Hanjingyu625/SafeStride/docs/HARDWARE.md

# 하드웨어 연결

## 전원

```text
12 V battery -> motor driver
            +-> XL4015 (5 V) -> Raspberry Pi -> USB -> Uno 2대
```

FND 표시가 12 V로 일정해도 Pi 단자의 5 V 순간 강하는 별도 측정해야 한다.
모터 기동 중 XL4015 출력, 배선 전압강하와 Pi undervoltage 기록을 확인한다.
배터리 전압 측정용 분압 회로는 아직 없으므로 Arduino A5에 12 V를 직접 연결하면
안 된다.

## Drive Uno

| 핀 | 연결 |
|---:|---|
| A3 | 왼쪽 휠 WSH135 `OUT`, 아날로그 기준점/히스테리시스 감지, 자석 12개 |
| D5/D6/D8 | 공통 모터드라이버 PWM/IN1/IN2 |
| A2/A1 | 왼쪽/오른쪽 압력센서, threshold 80 |
| A0/A4 | 선택적 전류센서 예약, 현재 비활성 |
| D12 | E-stop placeholder, currently unused |
| D13 | 선택적 driver fault, 기본 비활성 |

두 모터는 한 드라이버 출력에 연결되므로 서로 다른 속도나 제자리 회전은 지원하지
않는다. 두 모터 합산 기동·정지전류가 드라이버, 퓨즈, 배선 허용치를 넘지 않는지
확인한다.

WSH135는 5 V 구동 선형 아날로그 센서다. 마킹이 보이는 평평한 면을 정면으로
보고 다리를 아래로 했을 때 왼쪽부터 `VDD -> 5V`, `GND -> GND`,
`OUT -> A3`로 연결한다. 출력에는 풀업/풀다운 저항을 달지 않는다. 필요하면
`OUT-GND` 사이에 0.01~0.1 uF 커패시터를 센서 바로 옆에 단다. 부팅 중 학습되는
약 2.5 V 무자계 기준을 오염시키지 않도록 전원을 넣을 때 자석을 떼어 둔다.
바퀴 지름은 23 cm, 반지름은 0.115 m로 설정한다.

## Terrain Uno

| 핀 | 연결 |
|---:|---|
| A4/A5 | TOF-10120(`0x52`)와 GY-521 MPU6050(`0x68`/`0x69`) SDA/SCL |
| GND | 모든 센서와 공통 GND |

TOF는 아래쪽을 향해 약 25 cm 높이에 고정하고 장착부 흔들림이 거리 변화로
들어오지 않게 한다.

## Raspberry Pi GPS

BE-220은 Pi GPIO UART를 통해 Raspberry Pi에 직접 연결하고, 운영 장치 이름은
`/dev/serial0` 또는 `/dev/ttyS0`, 기본 baudrate는 115200이다. 실행 스크립트가
두 경로를 자동 선택하며 필요하면 `SAFESTRIDE_GPS_PORT`로 지정한다. GPS와 Pi의
GND를 공유하고 TTL 전압 레벨이 Pi 입력 허용 범위와 맞는지 확인한다.
