Hanjingyu625/SafeStride/docs/SPEED_CONTROL_KO.md

# SafeStride 속도제어 — pdj1

현재 동작: 내리막 5°가 0.5초 지속되어 확정되면 BRAKE/PWM 0.

기준: 현재 저장소의 실행 코드와 설정.
이 문서는 코드 동작과 초기 튜닝값을 설명한다. 실제 지면 속도·정지거리·경사 위
정지 유지 성능은 아직 측정하지 않았다.

## 1. 제어 흐름

```text
Terrain Uno MPU6050 → USB → terrain bridge → /terrain/status
                                                 ↓
/cmd_vel → safety supervisor → /drive/command (DriveCommand)
                                   ↓
                              serial bridge
                                   ↓ USB protocol v6
Drive Uno: 목표 ramp → FF + Hall P → 방향/상한 제한 → PWM slew → 모터드라이버
                ↑                                       ↓
          A3 WSH135, 12 pulse/rev                   모터 두 개 공통 구동
```

`/cmd_vel_safe`는 감독된 목표속도를 관찰하기 위한 `TwistStamped`로 유지한다.
실제 bridge 입력은 `/drive/command`이며 목표속도·경사 FF·상한·mode가 한 메시지다.
속도와 경사 보정을 별도 토픽으로 보내 이전 보정이 새 속도에 섞이게 하지 않는다.

주요 코드:

- `firmware/safestride_mcu/config.h`, `motor_control.cpp`: FF, Hall, PWM, BRAKE.
- `src/safestride_control/safestride_control/safety_logic.py`: 경사 분류와 BRAKE 복구.
- `safety_supervisor_node.py`: 센서 freshness, 속도 제한, 원자 명령 발행.
- `src/safestride_bridge/safestride_bridge/serial_bridge_node.py`: 명령 검증·직렬 전송.
- `config/raspberry_pi.yaml`, `src/safestride_bringup/config/safestride.yaml`: 실행 설정.

## 2. 평지 출력과 속도 피드백

PWM은 Arduino `analogWrite()`의 **0~255 count**다. 60은 60%가 아니라 약 23.5%
duty다. 30은 약 11.8%, 현재 상한 140은 약 54.9%다.

```text
wheel_radius = 0.115 m
v_nom = 1.0 m/s
omega_nom = 1.0 / 0.115 ≈ 8.696 rad/s

u_ff = sign(omega_ref) × [30 + (60 - 30) × abs(omega_ref) / omega_nom]
u_P  = 12 × (omega_ref - omega_measured)     # rad/s 단위
u_raw = u_ff + u_slope + u_P
```

목표가 0이면 BRAKE다. 매우 작은 ramp 목표(|목표| < 20 mrad/s)의 FF도 0이다.
`30`은 계산 bias이며 출력 하한이 아니다. 전진 목표에서 출력은 0~cap, 후진에서는
-cap~0으로 제한하므로 감속 중 30 아래나 0까지 내려갈 수 있다. 속도 오차만으로
목표 반대 방향 PWM을 만들지 않는다. Ki=Kd=0을 코드 assertion으로 고정했다.

평지에서 목표·측정 속도가 모두 1.0 m/s이면 모델 출력은 약 60이다.
이는 실측 보정 전 초기 기준이며, 부하에 따라 P 항이 출력을 수정한다.
기존 `MOTOR_FEEDFORWARD=10`과 deadzone bias 중복 덧셈은 제거했다.

최초 전진 구동은 제어 출력과 cap 범위 내에서 PWM 20까지 바로 시작한다.
이후 정상 PWM 크기는 상승 20 count/s, 하강 60 count/s로 제한한다. 출력
20→60은 목표·오차가 충분하더라도 약 2초 이상 걸린다. Pi 목표속도 slew 및 MCU
목표각속도 ramp와 최종 PWM slew는 별개다. 새 cap은 즉시 지킨다.
BRAKE·fault·watchdog은 정상 slew를 기다리지 않는다.

## 3. 경사 보정

정규화는 `(pitch_rad - pitch_offset_rad) * uphill_pitch_sign` 순서다.
현재 supervisor offset `0 rad`, sign `-1`이다. Pitch 양수는 내리막, 음수는 오르막이다.
Terrain bridge가 평지 기준 Pitch `-0.116 rad`(-6.646310°), Roll `-0.059 rad`(-3.380451°)를
한 번 빼서 `/terrain/status`를 발행한다. Foxglove와 HMI, 경사 제어는 이 보정값을 사용한다.
supervisor와 HMI의 추가 offset은 `0`으로 유지해 중복 보정을 피한다.
아래 각도는 모두 보정 후 값이다. `/terrain/imu`는 중력 제거 계산과 일관되도록
센서 좌표계의 기존 자세·가속도를 유지한다. 현재 영점은 평지 화면 한 장 기준이므로
재장착 시에는 정지 상태의 여러 샘플로 `terrain_bridge.attitude` 설정을 다시 보정한다.

아래 표는 기본 Cruise 요청 1.0 m/s와 현재 Pi 설정 기준이다.

| 보정 후 Pitch / 조건 | 목표속도와 출력 동작 |
|---|---|
| 평지 | 목표속도 1.0 m/s |
| 내리막 +5° 미만 (평지에서 진입) | 목표속도 1.0 m/s 유지 |
| 내리막 +5° 이상 0.5초 유지 | 목표 0과 BRAKE를 보내 PWM 즉시 0, IN1/IN2 LOW |
| 내리막 +7° 이상, 5° 확정 전 | 진입 당시 PWM에서 3초 감속을 먼저 시작; 5° 확정 시 BRAKE/PWM 0이 우선 |
| 확정 내리막 후 +3° 이하 | 0.5초 유지 시 평지로 복귀하고 정상 출발 경로 재개 |
| 오르막 -5° 이하 0.5초 유지 | 목표속도 1.0 m/s 유지, 최대 +30 PWM 경사 FF |

오르막 상태는 -3°까지의 히스테리시스로 유지되며, 양의 경사 FF는 -5°보다
완만해지면 0이 된다. 속도 피드백과 손잡이/통신 정지는 표보다 우선한다. ToF는 현재 모니터링 전용이다.
FF 60은 명목속도의 계산값이며 PWM 하한이 아니다. Ki=0을 유지한다.
PWM을 0으로 줄이는 시간과 실제 보행기의 제동거리/정지시간은 별도로 검증한다.

Pi 실행 시 다른 checkout의 설정이 환경변수에 남지 않도록 경로를 명시한다:

```bash
cd /home/pi/SafeStride-pdj1
SAFESTRIDE_CONFIG="$PWD/config/raspberry_pi.yaml" SAFESTRIDE_ENABLE_FOXGLOVE=true bash scripts/run.sh
```

경사 상태 진입 5°, 이탈 3°, 확인 0.5초의 히스테리시스를 사용한다.
오르막 목표속도 배율은 **1.0**으로 요청 속도를 유지하고 PWM 보상만 더한다.
기존 최대 전진속도 1.15 m/s와 가감속 제한은 유지한다. `downhill_speed_scale=1.0`이며
확정 내리막은 속도 배율 대신 `BRAKE`로 처리한다. 5° 확정 전 +7°가 먼저 감지되면
기존 3초 PWM 감속을 시작하지만, 0.5초 뒤 내리막이 확정되면 즉시 PWM 0이 우선한다.
이 7° 감속이 시작된 경우 MCU는 경사가 해제된 뒤에도 남은 감속 시간을 0 출력으로 완료한다.
평지 복귀는 +3° 이하가 0.5초 지속돼야 한다. 속도 피드백, 손잡이 및 통신 정지는
그대로 우선한다. ToF 정지는 현재 비활성이다. PWM 상한 140은 ROS 명령·브리지·Drive MCU에
함께 적용하므로 Pi 소프트웨어와 Drive 펌웨어를 함께 갱신해야 한다.

| 확정 상태 | 경사 FF (PWM count) |
|---|---|
| 평지 | 0 |
| 오르막 | `min(30, max(0, 5 × (각도 - 3)))` |
| 내리막 | 0 |

오르막 FF는 보정 후 -5° 이하이고 오르막 상태가 확정됐을 때 적용한다.
보정 후 -5°에서 +10, -7°에서 +20, -9° 이하에서 +30이다. 기본 FF 60은 명목속도에서의
계산값이지 실제 PWM 하한이 아니다. 실제 출력은 FF와 P, PWM 상한과 slew로 결정된다.
후진 명령에는 전진 기준 경사 FF를 적용하지 않는다. MPU의 현재 pitch는 가속도
기반 추정이므로 가감속·충격 영향을 받는다. 위 값은 검증된 보행 안전 기준이 아니다.

## 4. BRAKE 유지와 자동 복귀

사용자가 지정한 [DFRobot DRI0042 제어 자료](https://wiki.dfrobot.com/dri0042/#tech_specs)를
기준으로 `IN1=LOW, IN2=LOW`를 BRAKE로 사용한다. `HIGH/HIGH`는 Vacant이며 사용하지 않는다.
PWM 핀은 0으로 두지만 보드 전원은 유지하고 BRAKE 핀 상태를 계속 유지한다.
전원 릴레이 차단이나 새 수동 재시작 잠금을 추가하지 않았다.

참고 자료는 **DRI0042**의 문서이며 장착품 명칭은 **SZH-GNP521**이다.
장착 보드 리비전의 일치와 실제 BRAKE 효과는 실물 확인 대상이다.
방향 전환에는 자료의 0.1초 초과 권고를 반영해 최소 150ms BRAKE를 비차단 방식으로 둔다.
역방향 PWM을 제동으로 사용하지 않는다.

| 조건 | 동작·복귀 |
|---|---|
| 보정 후 pitch ≥ +5°가 0.5초 지속 | 확정 내리막 BRAKE. 목표 0, PWM 0, IN1=IN2=LOW. +3° 이하가 0.5초 지속되면 자동 복귀 |
| 보정 후 pitch ≥ +7°, 확정 전 | MCU TERRAIN_STOP으로 3초 PWM 감속 시작. 내리막 확정 시 BRAKE가 우선 |
| MPU invalid, fault, nonfinite 또는 stale | BRAKE 명령 스트림 유지. 유효 복구 조건에서 자동 재개 |
| 새 Hall 구간속도 >8 km/h가 2회 연속 관측 | MCU BRAKE |
| 과속 후 새 Hall 구간속도 <7 km/h | 자동 복귀 |
| 과속 후 새 pulse가 5초간 없음 | 무펄스 복구 조건으로 자동 복귀 가능. 물리 정지를 증명하지 않음 |
| 요청속도 0 | BRAKE. 정상 손 해제 ramp는 아래 예외 |

목표 대비 일반 속도 오차는 Hall P 제어가 PWM을 낮춰 보정한다. MCU의 독립적인
하드 BRAKE는 절대속도 8 km/h를 넘는 새 pulse-period가 2회 연속 관측될 때만
작동한다. 같은 저해상도 측정값을 200Hz 제어 주기마다 반복해 지속 과속으로
오인하지 않는다. 12 pulse/rev의 관측 지연 때문에 즉각적인 과속 감지는 불가능하다.

**기존** 양손 dead-man, 통신 watchdog, 하드웨어 fault, 수동 inhibit는 유지했다.
정상 손 해제는 기존 600ms 동안 직전 출력부터 단조 감소시킨다. E-stop 설정은
기존과 같이 비활성이며, 통신/하드웨어 fault는 기존 상태기계의 정지·복구 절차를 따른다.
새 경사 BRAKE 자체는 `ARMED`를 유지하므로 별도 재시작 버튼을 요구하지 않는다.

단락 BRAKE는 기계식 주차 브레이크가 아니다. 영속도에서 경사 위 위치를 유지하거나
전원이 없는 상태에서 제동을 보장하지 않는다. 이 구현에 기계적 HOLD는 없다.

## 5. Hall 5초 설정과 측정의 의미

한 pulse 이동거리는 `2π × 0.115 / 12 ≈ 0.0602 m`다.

| 실제 속도 | pulse 간격 |
|---:|---:|
| 0.08 m/s | 0.75초 |
| 0.048 m/s | 1.25초 |
| 0.04 m/s | 1.51초 |
| 0.032 m/s | 1.88초 |

`HALL_ZERO_TIMEOUT_US=5000000`으로 연장했다. 유효 speed는 pulse period가
20ms 이상·5초 미만이고 마지막 pulse age도 5초 미만인 경우다. 첫 pulse만으로는
속도를 만들지 않는다. 필터는 새 pulse가 들어올 때만 갱신한다.
5초 이후 표시 속도는 0으로 정리하되 `speed_valid=false`로 구분하고 P에는 넣지 않는다.

초기/무효 측정에서는 P=0, FF 요구를 최대 60으로 제한한다. 이미 더 큰 출력으로
주행했다면 정상 하강 slew로 줄어든다. 무펄스 구동 감시는 30 미만 출력도 포함하며
`max(5초, 예상 pulse 간격 × 2.5)`를 쓰되 최대 10초로 제한했다. 따라서 0.032 m/s에서
최소 5초, 0.08 m/s에서는 최소 5초를 기준으로 스톨을 감시한다.
5초는 속도 age timeout이며 스톨 timeout과 같지 않다.

12자석에서 8 km/h의 펄스 간격은 약 27.1ms다. 20ms pulse 무시 구간은
이 속도를 검출할 수 있다. ADC 30/12 히스테리시스는 유지했다.
빠른 ADC pulse를 실제 입력 검출 경로로 통과시키는 회귀 테스트를 추가했다.
노이즈·자석 폭·배선 EMI에 따른 오검출은 실물 튜닝이 필요하다.

## 6. 진단과 업데이트

2026-09-09 설정: 자석 12개, 과속 BRAKE 진입 8 km/h 초과의 새 구간속도
2회 연속 확인, 해제 7 km/h 미만. 두 번째 확인 즉시 PWM 0을 적용한다.
Hall 물리 상한은 25 rad/s(10.35 km/h)로 높여 8 km/h 전에 fault가 걸리지
않게 했다. 주행 목표속도와 PWM 상한은 별도 설정이다.

ROS 제어·표준 메시지 단위는 m/s, rad/s를 유지하고 다음 km/h 표시를 제공한다.

| 토픽 | km/h 값 |
|---|---|
| `/wheel/hall` | `left_speed_kmh`, `right_speed_kmh` |
| `/walker/status` | `measured_speed_kmh` |
| `/drive/command` | `target_speed_kmh` (표시용) |
| `/crosswalk/status` | `target_speed_kmh` |
| `/gps/speed_kmh`, `/gps/speed_raw_kmh` | `data` |
| `/odom_kmh`, `/cmd_vel_kmh`, `/cmd_vel_safe_kmh` | `data` (전후진 선속도) |

마지막 두 행은 launch에서 시작하는 `speed_display`가 원본 메시지 수신 시
발행한다. 원본이 끊기면 표시 토픽도 발행을 멈춘다. Foxglove Speed 축도 km/h다.
메시지 정의가 추가됐으므로 Pi에서 인터페이스와 관련 ROS 패키지를 함께 재빌드하고
노드를 재시작해야 한다. Drive Uno에는 12자석 설정 펌웨어를 업로드해야 한다.

`/walker/status`에 `ff_pwm`, `feedback_pwm`, `applied_pwm`, `measured_speed_m_s`,
`speed_age`, `speed_valid`, `new_pulse`, `braking`, `direction_valid`가 있다.
`new_pulse`는 직전 성공 telemetry 전송 이후 pulse가 있었음을 뜻한다.
오른쪽 속도는 왼쪽 복제값이고 `direction_valid=false`다.
상태 메시지가 반복돼도 새로운 물리 측정이 생긴 것은 아니다.

`/diagnostics`에는 정규화 pitch·경사 상태·목표속도·slope FF·MCU PWM·속도 age/valid와
BRAKE 상태를 기록한다. 명시적 경사·과속 BRAKE 처리 시 MCU FF/P 표시값과 applied PWM은 0이다.

프로토콜 **v6 / schema 0x0601 / release 20260908**은 이전 버전과 호환되지 않는다.
COMMAND는 12 bytes, Drive telemetry는 54 bytes다. [상세 형식](../PROTOCOL.md).
**Drive Uno, Terrain Uno, Pi ROS 메시지와 노드를 함께 갱신**해야 한다.

```bash
# Pi에서 저장소를 pdj1로 갱신한 뒤, 구동 서비스를 정지한 상태에서 수행
bash scripts/build.sh
arduino-cli compile --fqbn arduino:avr:uno firmware/safestride_mcu
arduino-cli compile --fqbn arduino:avr:uno firmware/terrain_mcu
# 포트 확인 후 각각 upload. 이 코드 작업에서는 실제 업로드하지 않았다.
arduino-cli upload --fqbn arduino:avr:uno -p /dev/safestride-drive firmware/safestride_mcu
arduino-cli upload --fqbn arduino:avr:uno -p /dev/safestride-terrain firmware/terrain_mcu
SAFESTRIDE_ENABLE_PERCEPTION=false SAFESTRIDE_REQUIRE_SURFACE_CONDITION=false \
  SAFESTRIDE_ENABLE_CRUISE=false bash scripts/run.sh
```

이전 `tools/windows_uno_test.ps1`은 v2 도구여서 이번 프로토콜에 사용하지 않는다.
읽기용 연결 검사는 현재 Python 프로토콜을 쓰는 `tools/serial_probe.py`를 사용한다.
노면 활성화 후속 계획은 [MCU README](../firmware/safestride_mcu/README.md)에 있다.

## 7. 검증과 다음 실물 시험

로컬 검증 결과: Drive/Terrain Uno AVR 컴파일과 C++ 호스트 펌웨어 8종 통과.
Python 62개(bridge/프로토콜 36, 감독 명령 7, 경사 정책 6, 설정 일치 13) 통과.
두 실행 YAML의 파싱 및 노면 비활성·오르막 배율 1.0 확인, Python compileall 통과.
최종 Drive 빌드는 flash 15,230/32,256 bytes, 전역 RAM 988/2,048 bytes,
Terrain은 flash 10,648 bytes, 전역 RAM 1,065 bytes다.
이 검사는 실제 DDS 통신, Pi에서의 ROS 실행, USB 연결, 모터 부하 시험을 대체하지 않는다.

Deployment note: nominal walking speed is 1.0 m/s; uphill target stays at 1.0 m/s with PWM assistance.
ROS forward limit is 1.15 m/s and bridge/MCU wheel limits are 10 rad/s.
FF 60 at 1.0 m/s is an initial model requiring loaded hardware calibration.
Deploy both ROS configuration and Drive Uno firmware together.

### ToF·노면 모니터링 설정

현재 기본 설정은 `terrain_stop_enabled=false`, `range_control_enabled=false`,
`require_range_sensors=false`, `surface_control_enabled=false`,
`require_surface_condition=false`이다. ToF 위험·오류, 전방 거리, 노면 분류와
권장 배율은 모터 명령을 변경하지 않는다. 영상과 센서·판정 토픽은 계속 발행한다.
MPU의 5도 확정 내리막 PWM 0과 7도 조기 감속, 손잡이·통신 보호는 유지한다.
