Hanjingyu625/SafeStride/docs/ROADMAP.md

# Integration roadmap

- [x] 왼쪽 A3 WSH135 Hall 12 pulse/rev와 압력 threshold 80 반영
- [x] TOF EMA, 적응 기준, 양방향 변화와 연속 검출 구현
- [x] GY-521 MPU6050 3축 가속도·자이로 구현
- [x] BE-220 GPS 기본 활성 및 지도/API readiness monitor 구현
- [x] ROS launch integration test와 안전한 HIL smoke test 추가
- [ ] 휠 반지름과 PID를 lifted-wheel 로그로 조정
- [ ] XL4015 5 V 과도응답과 모터 기동 시 Pi undervoltage 측정
- [ ] TOF를 발, 경사, 반사면, 구멍 조건에서 데이터 수집 후 임계값 조정
- [ ] 횡단보도 지도와 신호 API를 준비한 뒤 관찰 로그로 검증
- [ ] 물리 E-stop 설치 및 독립 전원 차단 검증
- [ ] 기계·전기 안전 검토 후 무부하 저속 시험
