Hanjingyu625/SafeStride/docs/SIGNAL_REALTIME_UPDATE_KO.md

# 실시간 신호 API 및 판단 변경 (2026-09-29)

## 이전 조회 방식의 실제 확인 결과

사용자가 승인받은 두 실시간 API를 기존 저장 키로 직접 확인했다.
승인 화면의 키 문자열과 로컬 `raspberry_pi/api_key.txt`가 일치했다.
광진구청 교차로 1697 조회에서 두 API 모두 HTTP 200을 반환했다.
이어 수정한 클라이언트로 약 1초 간격 5회 조회하여 모두 정상 수신했다.
동/서 보행신호는 빨간불이었고 잔여시간은 36001(사용 불가)이었다.
빨간불은 잔여시간 없이도 확인되므로 이 응답은 '신호 없음'이 아니라 '기다려'다.
녹색 판정은 테스트 데이터로 검증했으며, 이번 실제 5회 수신은 모두 빨간불이었다.

## API와 자동 실행

기본 요청 주소는 승인 화면과 동일하다.

- 현시: `https://t-data.seoul.go.kr/apig/apiman-gateway/tapi/v2xSignalPhaseCurrentInfo/1.0`
- 잔여시간: `https://t-data.seoul.go.kr/apig/apiman-gateway/tapi/v2xSignalPhaseTimingCurrentInfo/1.0`

둘 다 소문자 `apikey`와 동일한 `itstId`로 병렬 조회한다.
현재 작업 트리(`a6a1a7b` 이후 0초 응답 처리 변경 포함)는 기본적으로 **잔여시간 만료 시 재조회**한다.
횡단보도 좌표는 로컬 JSON, 교차로 지도는 디스크 파일/캐시를 사용한다.
선택 횡단보도 가장자리 20m 안에서 단일 보행 신호 방향이 확인되면 빨강·초록 모두
현시와 잔여시간 API를 병렬 조회한다(한 조회에 HTTP 요청 두 건).
최초 응답은 원본 나이 12초 이내인지 검증하고, 수용한 현시의 종료 시각까지
라즈베리파이가 잔여시간을 계산한다. 20초 남은 원본이 2초 늦게 도착하면 18초 후
재조회하며, 그동안 3초 주기 조회는 하지 않는다. 만료 후에는 새 응답이 있어야
신호색을 다시 판단한다. 보고된 종료 전 현장 신호 변경을 즉시 감지하지 못하는 한계가 있다.

`signal_refresh_interval_s=3`은 실패·누락 및 새 선택 시 최소 요청 간격이다.
서버가 지정한 HTTP 오류 대기는 유지한다. 잔여 호출량으로 평균 간격을 계산하는
자동 pacing은 이 노드에서 끄며, 과거 pacing 캐시도 재사용하지 않는다.
빨강 잔여시간이 없으면 원본 나이 12초 안에서 대기를 표시하며 재조회한다.
잔여시간이 **0으로 응답되면 빨강 색상은 원본 12초 동안 유지**하고, 응답 수신 후
2초 간격으로 최대 3회 추가 조회한다. 초록 0초도 같은 재조회 제한을 적용하되 진입은 불허한다.
계속 0이거나 실패하면 3회 후 해당 교차로·방향의 자동 조회를 중단한다. 선택 변경으로
횟수를 초기화하지 않는다. 유효한 양수 시간이 새로 관측되거나 노드가 재시작되면 해제된다.
중복 원본은 색상 유효기간을 연장하지 않으며, 서버 오류 대기는 2초 간격보다 우선한다.
이 0초 예외에서는 표시용 잔여시간은 null, 진입 계산용 빨강 시간은 0이다.
녹색 잔여시간이 없으면 진입을 허용하지 않는다.
`signal_countdown_s`는 현재 빨강/초록 잔여시간이고, 기존 `signal_remaining_s`는
녹색 시간 예산이므로 빨강에서는 0이다.
자세한 조건은 [속도·신호 역치 문서](SPEED_CHANGE_THRESHOLDS_KO.md)의 최신 절을 따른다.

원본 시각은 관측 중 약 2초 단위로 갱신되기도 했다. 1초 조회가 서버 갱신을
빠르게 만들지는 않는다. 동일 응답을 새 데이터로 취급하지 않고 원본 시각을 사용한다.
HTTP 429는 응답 JSON 내부 `X-RateLimit-Reset`도 읽는다. 2026-09-29 15:59:40 KST의
실제 응답 `28819초`는 23:59:59 KST에 해당하여 현재 제한은 자정 초기화로 관측됐다.
로컬 캐시 삭제로 서버 사용량은 초기화되지 않는다.
신호를 잃어도 오래된 데이터를 계속 유효하게 연장하지 않는다.

## 횡단보도와 신호 그룹 매칭

서울시 공식 설명에서 보행신호 방향은 횡단보도 자체의 방위가 아니다.
차량이 직진할 때 그 횡단보도를 오른쪽에 두는 진입 방향의 신호 그룹을 사용한다.
따라서 교차로 서쪽 횡단보도는 `wtPdsg*`가 아니라 `ntPdsg*`에 해당한다.
코드는 교차로 중심에서 횡단보도로 향하는 방위에 90도를 더한 뒤,
횡단보도 장축과 일치하는지 확인해 `nt/et/st/wt` 또는 대각선 그룹을 고른다.
연결된 방향만 판정하며 다른 방향의 색이나 잔여시간으로 후보를 제외하거나 값을 합치지 않는다.
2026-09-30 로컬 변경 (`8b80341` 이후): 기하가 애매하면 같은 교차로의 이전 확정
방향에 가까운 후보를 임시 조회한다. 확정 이력이 없으면 유지되는 랜덤 후보 하나를
선택하고 정상 신호 검증·진입 판단에 사용한다. 랜덤 선택의 출처는 `random_candidate`로
남기며 실제 횡단보도와 신호 그룹의 일치를 보장하지 않는다. API 응답 유효성·색·잔여시간
검증은 유지한다. 이전 확정 방향 기반 임시 조회는 `provisional_signal_*`에만 제공한다.
교차로 중심 최소 거리 역치는 1m다. 자세한 기준은 SPEED_CHANGE_THRESHOLDS_KO.md 최신 절을 따른다.

공개된 `신호연결 MAP 정보` CSV도 확인했으나 차량 차로의 직진/좌회전/우회전 연결만
포함하고 보행 횡단보도 좌표나 보행신호 연결은 포함하지 않는다. 이 파일은 현재
보행신호 매칭을 대체할 수 없다.

신호 주기는 시간대, 보행자 버튼, 교통 대응 및 현장 설정에 따라 달라질 수 있으므로
관측한 반복 주기를 실제 녹색 또는 진입 허가로 사용하지 않는다. 대회 시연도 20m 안에서
받은 실시간 현시를 사용하며, API가 없으면 `신호 없음`으로 표시한다.

기존 `scripts/run.sh`와 서비스 시작 방식은 그대로 사용한다. 키는 매번 입력하지 않는다.
노드 자체도 다음 순서로 저장된 키를 자동 로드한다.

1. 명시한 `api_key_file`, 또는 `SAFESTRIDE_SIGNAL_API_KEY_FILE` 경로
2. 별도 지정이 없으면 `/etc/safestride/signal_api_key.txt`
3. 위 기본 파일에 키가 없으면 체크아웃의 `raspberry_pi/api_key.txt`

명시한 경로가 잘못됐을 때 다른 키로 몰래 바꾸지는 않는다.
run.sh가 전달하는 키 경로가 있으면 그 경로가 우선한다. 서비스 재시작 시 자동으로 읽는다.
현재 저장 키가 새 승인 키와 같으므로 키 내용 교체는 필요하지 않았다.

## 직관적인 판단

| 상황 | guidance decision | 표시 |
|---|---|---|
| 진입 지점에서 녹색이고 필요한 시간이 충분 | GO | 건널 수 있음 |
| 진입 전 빨간불 또는 녹색 시간이 부족 | WAIT | 기다려 |
| 횡단 중 남은 시간이 부족하거나 ETA/완료 확인 불가 | CAUTION | 주의 |
| 신호 누락, 오래된 신호, 방향/현시/필수 잔여시간 미확정 | NO_SIGNAL | 신호 없음 |

접근 중에는 진입 지점에서 재확인하도록 WAIT를 유지한다.
선택된 횡단보도가 없거나 횡단 완료 상태에는 NONE/안내 없음이다.
횡단 중 신호가 사라지면 NO_SIGNAL로 실제 신호 확인을 안내한다.
이미 도로 위에 있을 때 진입 전 '기다려' 판단으로 되돌리지 않는다.

진입 필요시간 = 횡단보도 길이 / 사용자 보행속도 + 반응 1초 + 여유 2초.
사용자 속도는 확인된 이동 표본의 중앙값이며, 대기 속도는 학습하지 않는다.
표본이 없을 때 기존 기본값 1.0m/s를 사용한다. 이 값은 실제 모터 속도 보장이 아니다.
예: 길이 10m, 사용자 속도 1m/s이면 13초가 필요하다. 남은 녹색 18초면 진입 가능,
10초면 대기다. 속도가 0.35m/s이면 약 31.6초가 필요하므로 18초에는 대기한다.

횡단 중 ETA = 남은 거리 / 현재 측정속도.
남은 녹색이 ETA + 2초보다 짧으면 주의다. 정지/속도 누락은 ETA 미확정이다.
시간 계산과 여유값 자체는 이번 변경으로 늘리거나 줄이지 않았다.
녹색은 실제 현시 이름으로 확인하고, 유효한 잔여시간에서 원본 데이터 나이를 뺀다.
36000/36001/-1은 잔여시간으로 사용하지 않는다. 빨간불의 남은 시간을 녹색 시간으로 쓰지 않는다.

## 호환성과 확인

`/crosswalk/status`의 내부 state 0~6, 횡단 시작/완료, GPS 후보 유지,
바퀴 이동 확인, 모터 제어 및 LCD 통신 형식은 유지한다.
LCD는 기존 status의 signal_valid/state를 계속 받는다. LCD 문구 자체는 변경하지 않았다.
사람이 읽을 판단은 `/crosswalk/guidance`의 decision/state/reason으로 확인한다.
signal_color는 RED/GREEN/UNKNOWN, 나머지 계산값과 매칭 원인도 함께 제공한다.
지도 기반 신호 방향은 공식 규칙에 맞춰 계산하지만 입력 좌표 오차가 있으므로
대회 전 대상 횡단보도에서 실제 신호등과 한 번 대조해야 한다.

```bash
ros2 topic echo /crosswalk/guidance
```

서비스와 중복 조회하지 않는 별도 점검 시 저장 키를 자동으로 사용한다.

```bash
python3 tools/probe_signal_current.py --intersection 1697 --samples 5
```

이 도구는 운영 코드와 같은 조회/파싱/오류 대기 로직을 사용하고 최대 30회로 제한한다.
구형 API를 조회하던 legacy-check 및 키 인자 대소문자 수동 선택 옵션은 제거했다.

검증: GPS/내비게이션 자동 테스트 통과. 실제 API 5회 연속 수신 성공.
이 변경의 Pi 재배포/현장 주행 결과를 의미하지는 않는다.
