Hanjingyu625/SafeStride/docs/analysis/ROSBAG_TIME_MARKERS_KO.md

# 로스백 분석용 시각 메모

| 시각(KST) | 시각(UTC) | 사용자 지정 내용 | 기록 파일 |
|---|---|---|---|
| 2026-09-28 18:06:37 +09:00 | 2026-09-28 09:06:37Z | 오르막·내리막(up/down hill) 로스백 분석 시 참고할 현재 시각 | 아직 확인하지 않음 |

사용자의 시각 표시 요청을 받은 뒤 PC 시계로 확인한 시각이다. 실제 경사 진입·종료 시각이나 녹화 시작 시각을 측정한 것은 아니다. 2026-09-27 기록과 구분하여 해당 날짜의 로스백에서 이 시각 전후를 확인한다.
