Hanjingyu625/SafeStride/docs/assets/road_surface_panel/road_surface_training_summary.pdf

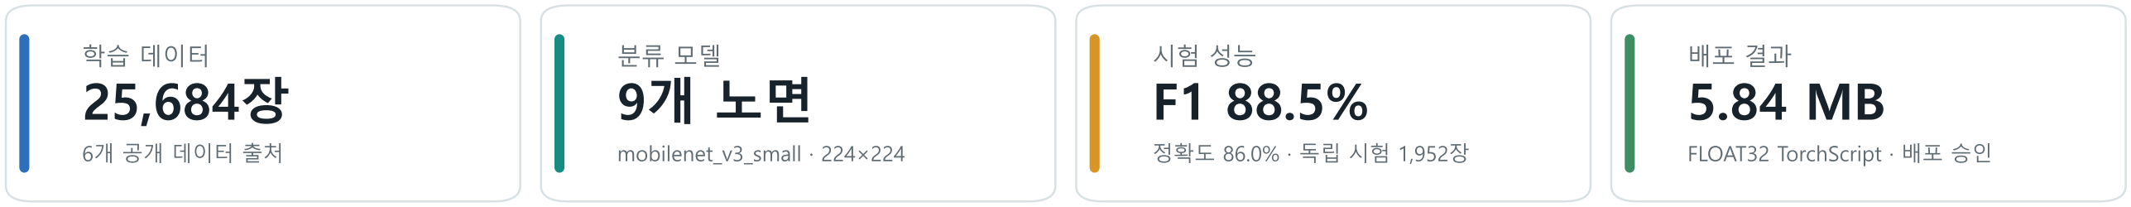
[picture p3: figure]
학습 데이터 25,684장; 6개 공개 데이터 출처; mobilenet_v3_small · 224×224; 정확도 86.0% · 독립 시험 1,952장; FLOAT32 TorchScript · 배포 승인
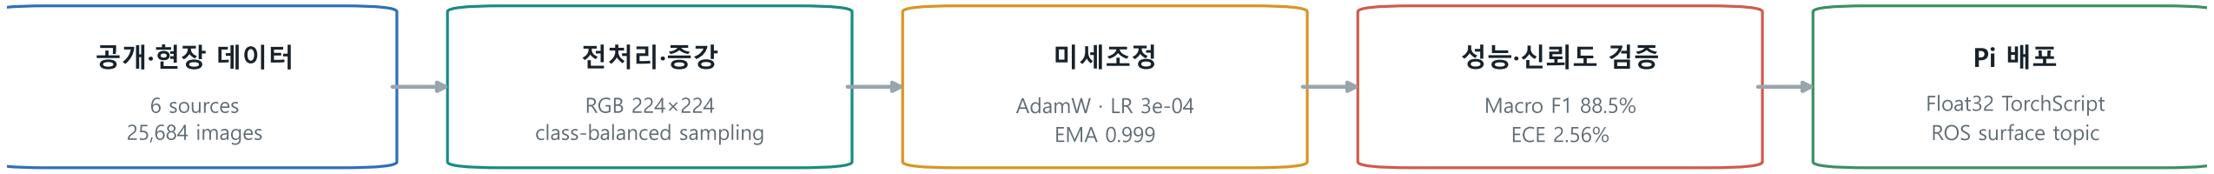
[picture p4: figure]
공개·현장 데이터; 6 sources 25,684 images; 전처리·증강; RGB 224×224 class-balanced sampling; 미세조정; AdamW · LR 3e-04 EMA 0.999; 성능·신뢰도 검증; Macro F1 88.5% ECE 2.56%; Float32 TorchScript ROS surface topic

# 데이터 출처별 이미지 수

# 핵심 학습 설정

Architecture | mobilenet_v3_small
Input | RGB 224×224
Optimizer / batch | AdamW / 128
Learning rate | 3e-04 / backbone 3e-05
Training schedule | max 30 epochs / early stop 7
Regularization | WD 1e-04 / smoothing 0.05
Model averaging | EMA 0.999
Train / val / test | 22,697 / 1,035 / 1,952

# 노면 인식 모델 학습 및 배포 개요

## SafeStride · MobileNetV3-Small · Raspberry Pi 실시간 추론

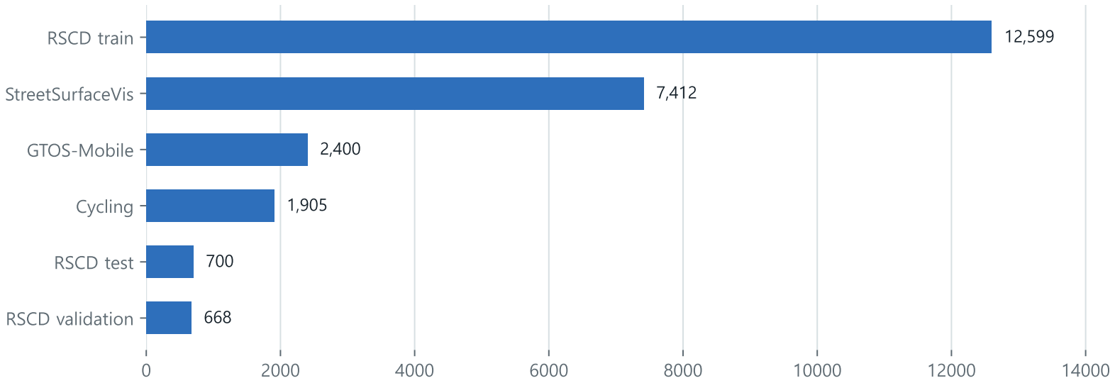
[picture p5: figure]
RSCD validation; RSCD test; Cycling; GTOS-Mobile; StreetSurfaceVis; RSCD train

제어 배율: smooth/rough/mud/unpaved 1.00×, block/gravel 0.95×, wet 0.85×, snow/ice 0.75×. INT8 PTQ는 성능 저하로 제외했습니다.
