Hanjingyu625/SafeStride/docs/assets/road_surface_panel/road_surface_training_summary.png

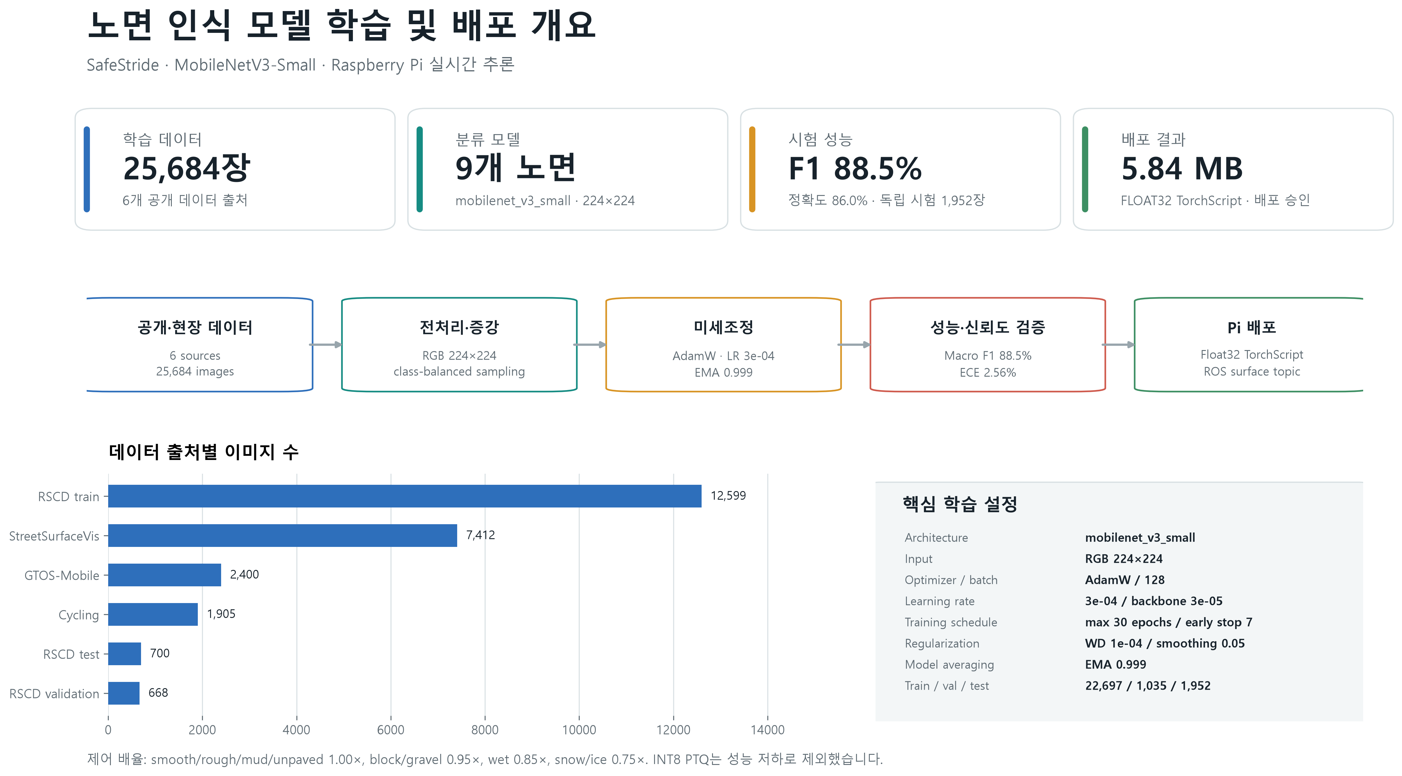
docs/assets/road_surface_panel/road_surface_training_summary.png
