Hanjingyu625/SafeStride/test/arduino_stub/README.md

# Arduino host stub

`Arduino.h`에는 desktop C++ compiler로 SafeStride 펌웨어의 문법을
검사하는 데 필요한 선언만 들어 있습니다. 이 파일은 보드 simulator가
아닙니다. 실제 보드에 업로드할 펌웨어를 컴파일할 때는 Arduino include
경로에 절대 추가하지 마십시오.
