Hanjingyu625/SafeStride/docs/assets/road_surface_panel/road_surface_test_performance.pdf

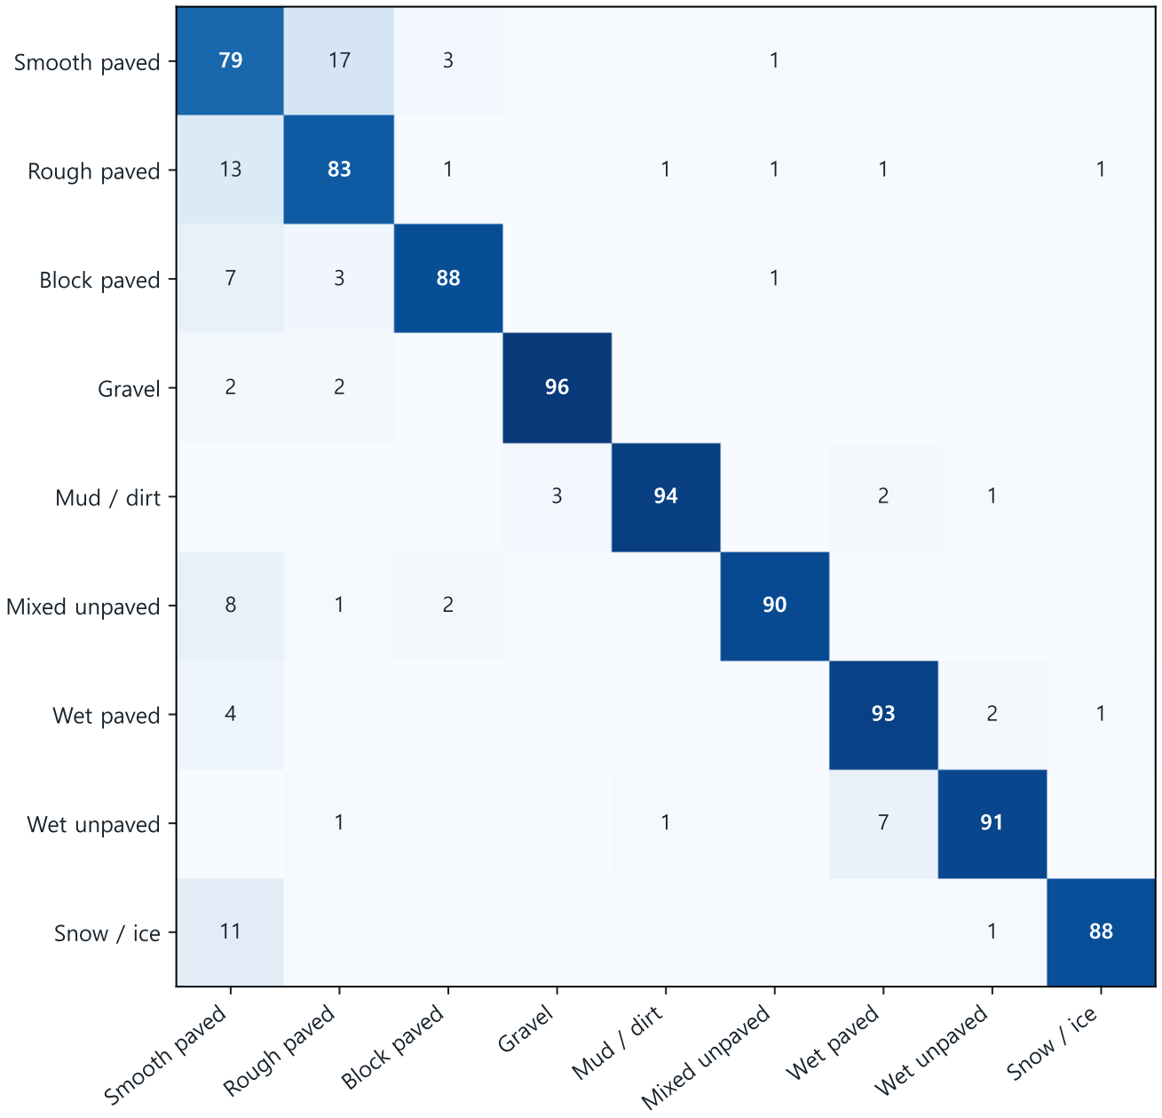
[picture p7: figure]
Smooth paved Rough paved Block paved; Gravel; Mud / dirt Mixed unpaved; Wet paved Wet unpaved; Snow / ice; Smooth paved; Rough paved; Block paved; Mud / dirt; Mixed unpaved; Wet paved; Wet unpaved

### Predicted

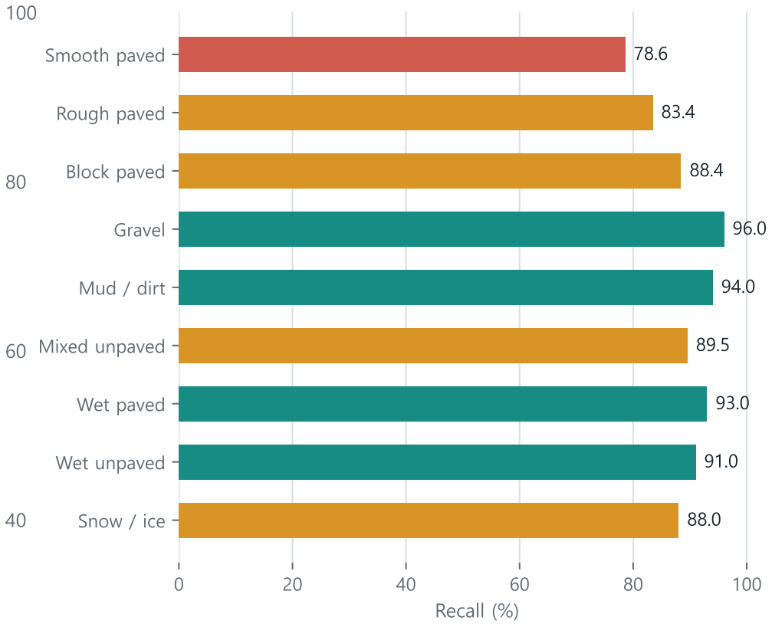
[picture p8: figure]
Recall (%); Smooth paved; Rough paved; Block paved; Gravel; Mud / dirt; Mixed unpaved; Wet paved; Wet unpaved; Snow / ice

### Actual

0

20

# Recall by class

## Merged dry-paved control group

# 8-group accuracy 92.7% · Macro F1 92.9%

Dry-paved recall 95.7% · F1 93.1%
Main confusion: smooth → rough 16.8%. Both labels use the same base speed.

# Road-Surface Classification Performance

### Held-out test set · Row-normalized confusion matrix

# 9-class accuracy 86.0% 9-class Macro F1 88.5%

Diagonal cells are correct predictions. Each row is normalized to 100% so classes with different support can be compared.
