Hanjingyu625/SafeStride/docs/assets/road_surface_panel/road_surface_test_performance.png

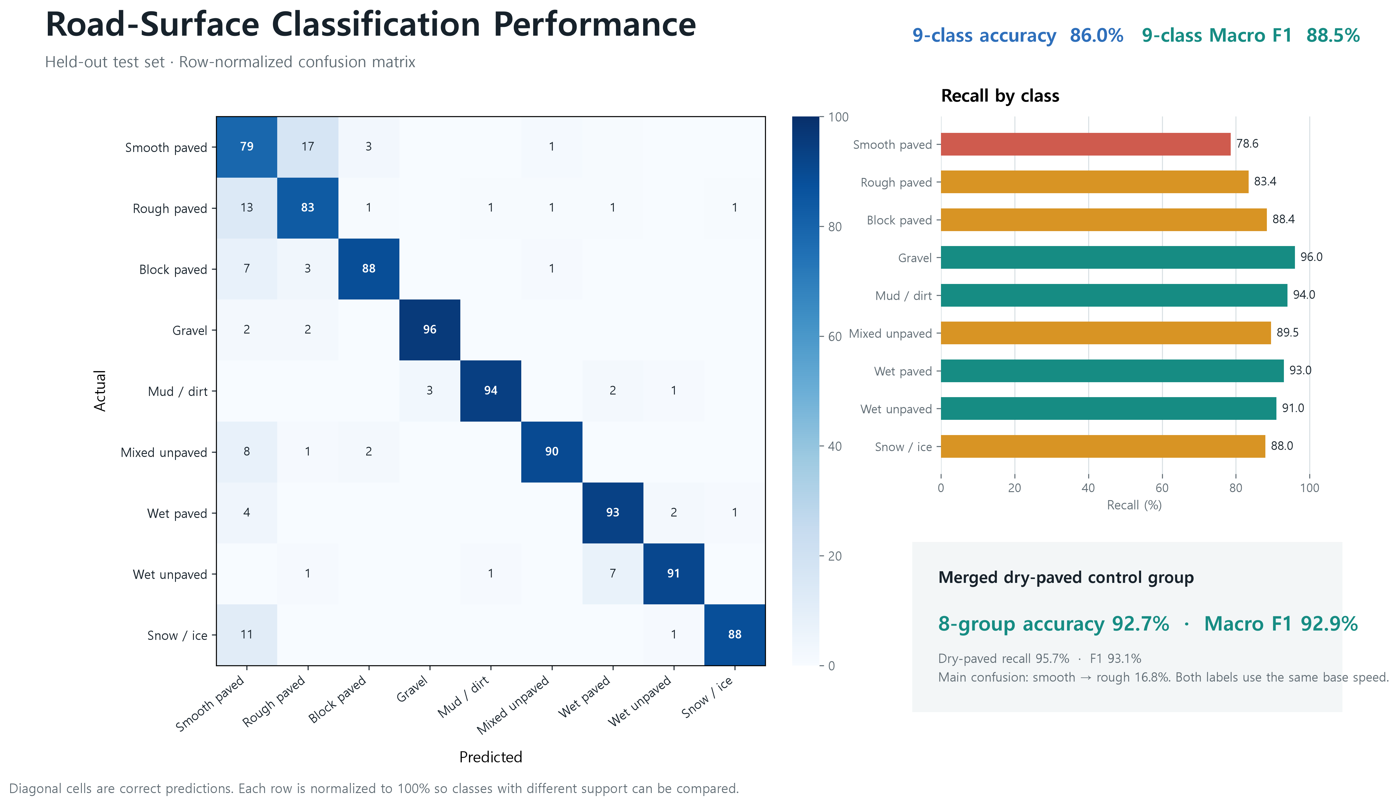
docs/assets/road_surface_panel/road_surface_test_performance.png
