Hanjingyu625/SafeStride/src/safestride_control/safestride_control/safety_supervisor_node.py

"""Fail-safe velocity-command supervisor for the SafeStride walker."""

import math
from typing import Dict, List, Optional, Tuple

import rclpy
from diagnostic_msgs.msg import DiagnosticArray, DiagnosticStatus, KeyValue
from geometry_msgs.msg import TwistStamped
from rclpy.node import Node
from rclpy.qos import (
    DurabilityPolicy,
    HistoryPolicy,
    QoSProfile,
    ReliabilityPolicy,
    qos_profile_sensor_data,
)
from sensor_msgs.msg import Range

from safestride_interfaces.msg import (
    DriveCommand,
    SurfaceCondition,
    TerrainStatus,
    WalkerStatus,
)
from .safety_logic import (
    SlopeSpeedPolicy,
    SlopeBrakePolicy,
    slope_feedforward_pwm,
    combine_speed_scales,
    finite_parameter,
)


def _clamp(value: float, low: float, high: float) -> float:
    return max(low, min(high, value))


def _bool_text(value: bool) -> str:
    return 'true' if value else 'false'


# Keep these internal: the user does not select a drive mode or enter a speed.
# PWM 35 is the hands-on launch cap, while 60 at 1.0 m/s mirrors the
# existing MCU feed-forward model. One Hall pulse represents this much travel
# with the installed 0.115 m wheel radius and twelve magnets.
_HANDS_ON_PWM = 35
_NOMINAL_ASSIST_PWM = 60
_NOMINAL_ASSIST_SPEED_M_S = 1.0
_HALL_METERS_PER_PULSE = 2.0 * math.pi * 0.115 / 12.0
# The MCU declares a no-pulse Hall fault after at least five seconds. Stop the
# launch aid first so holding the handles while standing cannot create a fault
# or leave a geared DC motor energised indefinitely.
_NO_PULSE_ASSIST_TIMEOUT_S = 4.0


class SafetySupervisor(Node):
    """Validate and limit motion commands before they reach the MCU bridge."""

    def __init__(self) -> None:
        super().__init__('safety_supervisor')

        self.declare_parameter('publish_rate', 20.0)
        self.declare_parameter('diagnostic_rate', 2.0)
        self.declare_parameter('command_timeout', 0.50)
        self.declare_parameter('status_timeout', 0.50)
        self.declare_parameter('max_telemetry_age', 0.50)
        self.declare_parameter('range_timeout', 0.35)
        self.declare_parameter('surface_timeout', 2.5)
        self.declare_parameter('require_range_sensors', False)
        self.declare_parameter('terrain_stop_enabled', False)
        self.declare_parameter('range_control_enabled', False)
        self._terrain_stopping = False
        self._terrain_stop_started = 0.0
        self._terrain_clear_since = None
        self._terrain_note = ''
        self.declare_parameter('require_surface_condition', False)
        self.declare_parameter('require_deadman', True)
        self.declare_parameter('slope_control_enabled', True)
        self.declare_parameter('surface_control_enabled', False)
        self.declare_parameter('drive_command_topic', '/drive/command')
        self.declare_parameter('brake_enter_deg', 7.0)
        self.declare_parameter('brake_release_deg', 3.0)
        self.declare_parameter('brake_recovery_s', 0.5)
        self.declare_parameter('drive_pwm_cap', 140)
        self._surface_control_enabled = bool(self.get_parameter('surface_control_enabled').value)
        self._brake_policy = SlopeBrakePolicy(
            self.get_parameter('brake_enter_deg').value,
            self.get_parameter('brake_release_deg').value,
            self.get_parameter('brake_recovery_s').value)
        self._drive_pwm_cap = int(finite_parameter('drive_pwm_cap',
            self.get_parameter('drive_pwm_cap').value, minimum=0.0, maximum=140.0))
        self._slope_braking = False
        self._slope_ff_pwm = 0

        self.declare_parameter('max_forward_velocity', 1.15)
        self.declare_parameter('max_reverse_velocity', 0.08)
        self.declare_parameter('max_angular_velocity', 0.35)
        self.declare_parameter('max_surface_speed_scale', 1.25)
        self.declare_parameter('max_linear_acceleration', 0.50)
        self.declare_parameter('max_linear_deceleration', 0.50)
        self.declare_parameter('max_angular_acceleration', 0.50)
        self.declare_parameter('max_angular_deceleration', 1.00)
        self.declare_parameter('slope_enter_angle_rad', math.radians(5.0))
        self.declare_parameter('slope_exit_angle_rad', math.radians(3.0))
        self.declare_parameter('slope_confirmation_time_s', 0.50)
        self.declare_parameter('uphill_pitch_sign', -1.0)
        self.declare_parameter('pitch_offset_rad', 0.0)
        self.declare_parameter('downhill_speed_scale', 1.0)
        self.declare_parameter('uphill_speed_scale', 1.0)
        self.declare_parameter('max_combined_speed_scale', 1.25)

        self.declare_parameter('stop_distance', 0.35)
        self.declare_parameter('slow_distance', 0.80)

        self.declare_parameter('command_topic', '/cmd_vel')
        self.declare_parameter('safe_command_topic', '/cmd_vel_safe')
        self.declare_parameter('left_range_topic', '/range/front_left')
        self.declare_parameter('right_range_topic', '/range/front_right')
        self.declare_parameter(
            'surface_topic', '/perception/surface_condition'
        )
        self.declare_parameter('status_topic', '/walker/status')
        self.declare_parameter('terrain_status_topic', '/terrain/status')
        self.declare_parameter('diagnostics_topic', '/diagnostics')
        self.declare_parameter('output_frame_id', 'base_link')

        self._publish_rate = finite_parameter(
            'publish_rate',
            self.get_parameter('publish_rate').value,
            minimum=0.0,
            maximum=200.0,
            minimum_inclusive=False,
        )
        self._diagnostic_rate = finite_parameter(
            'diagnostic_rate',
            self.get_parameter('diagnostic_rate').value,
            minimum=0.0,
            maximum=100.0,
            minimum_inclusive=False,
        )
        self._command_timeout = finite_parameter(
            'command_timeout',
            self.get_parameter('command_timeout').value,
            minimum=0.0,
            maximum=10.0,
            minimum_inclusive=False,
        )
        self._status_timeout = finite_parameter(
            'status_timeout',
            self.get_parameter('status_timeout').value,
            minimum=0.0,
            maximum=10.0,
            minimum_inclusive=False,
        )
        self._max_telemetry_age = finite_parameter(
            'max_telemetry_age',
            self.get_parameter('max_telemetry_age').value,
            minimum=0.0,
            maximum=10.0,
            minimum_inclusive=False,
        )
        self._range_timeout = finite_parameter(
            'range_timeout',
            self.get_parameter('range_timeout').value,
            minimum=0.0,
            maximum=10.0,
            minimum_inclusive=False,
        )
        self._surface_timeout = finite_parameter(
            'surface_timeout',
            self.get_parameter('surface_timeout').value,
            minimum=0.0,
            maximum=10.0,
            minimum_inclusive=False,
        )
        self._require_ranges = bool(
            self.get_parameter('require_range_sensors').value
        )
        self._require_surface = bool(
            self.get_parameter('require_surface_condition').value
        )
        self._require_deadman = bool(
            self.get_parameter('require_deadman').value
        )
        self._slope_control_enabled = bool(
            self.get_parameter('slope_control_enabled').value
        )
        self._max_forward = finite_parameter(
            'max_forward_velocity',
            self.get_parameter('max_forward_velocity').value,
            minimum=0.0,
            maximum=10.0,
        )
        self._max_reverse = finite_parameter(
            'max_reverse_velocity',
            self.get_parameter('max_reverse_velocity').value,
            minimum=0.0,
            maximum=10.0,
        )
        self._max_angular = finite_parameter(
            'max_angular_velocity',
            self.get_parameter('max_angular_velocity').value,
            minimum=0.0,
            maximum=20.0,
        )
        self._max_surface_scale = finite_parameter(
            'max_surface_speed_scale',
            self.get_parameter('max_surface_speed_scale').value,
            minimum=1.0,
            maximum=2.0,
        )
        self._linear_accel = finite_parameter(
            'max_linear_acceleration',
            self.get_parameter('max_linear_acceleration').value,
            minimum=0.0,
            maximum=20.0,
        )
        self._linear_decel = finite_parameter(
            'max_linear_deceleration',
            self.get_parameter('max_linear_deceleration').value,
            minimum=0.0,
            maximum=20.0,
            minimum_inclusive=False,
        )
        self._angular_accel = finite_parameter(
            'max_angular_acceleration',
            self.get_parameter('max_angular_acceleration').value,
            minimum=0.0,
            maximum=50.0,
        )
        self._angular_decel = finite_parameter(
            'max_angular_deceleration',
            self.get_parameter('max_angular_deceleration').value,
            minimum=0.0,
            maximum=50.0,
            minimum_inclusive=False,
        )
        slope_enter_angle = finite_parameter(
            'slope_enter_angle_rad',
            self.get_parameter('slope_enter_angle_rad').value,
            minimum=0.0,
            maximum=0.7854,
            minimum_inclusive=False,
        )
        slope_exit_angle = finite_parameter(
            'slope_exit_angle_rad',
            self.get_parameter('slope_exit_angle_rad').value,
            minimum=0.0,
            maximum=0.7854,
        )
        slope_confirmation_time = finite_parameter(
            'slope_confirmation_time_s',
            self.get_parameter('slope_confirmation_time_s').value,
            minimum=0.0,
            maximum=10.0,
        )
        uphill_pitch_sign = finite_parameter(
            'uphill_pitch_sign',
            self.get_parameter('uphill_pitch_sign').value,
            minimum=-1.0,
            maximum=1.0,
        )
        if uphill_pitch_sign not in (-1.0, 1.0):
            raise ValueError('uphill_pitch_sign must be +1.0 or -1.0')
        pitch_offset = finite_parameter(
            'pitch_offset_rad',
            self.get_parameter('pitch_offset_rad').value,
            minimum=-math.pi,
            maximum=math.pi,
        )
        downhill_speed_scale = finite_parameter(
            'downhill_speed_scale',
            self.get_parameter('downhill_speed_scale').value,
            minimum=0.0,
            maximum=1.0,
        )
        uphill_speed_scale = finite_parameter(
            'uphill_speed_scale',
            self.get_parameter('uphill_speed_scale').value,
            minimum=1.0,
            maximum=2.0,
        )
        self._max_combined_speed_scale = finite_parameter(
            'max_combined_speed_scale',
            self.get_parameter('max_combined_speed_scale').value,
            minimum=1.0,
            maximum=2.0,
        )
        self._slope_policy = SlopeSpeedPolicy(
            enter_angle_rad=slope_enter_angle,
            exit_angle_rad=slope_exit_angle,
            confirmation_time_s=slope_confirmation_time,
            uphill_pitch_sign=uphill_pitch_sign,
            pitch_offset_rad=pitch_offset,
            downhill_speed_scale=downhill_speed_scale,
            uphill_speed_scale=uphill_speed_scale,
        )

        self._stop_distance = finite_parameter(
            'stop_distance',
            self.get_parameter('stop_distance').value,
            minimum=0.0,
            maximum=100.0,
            minimum_inclusive=False,
        )
        self._slow_distance = finite_parameter(
            'slow_distance',
            self.get_parameter('slow_distance').value,
            minimum=0.0,
            maximum=100.0,
            minimum_inclusive=False,
        )
        if self._slow_distance <= self._stop_distance:
            raise ValueError(
                'slow_distance must exceed stop_distance'
            )

        self._output_frame_id = str(
            self.get_parameter('output_frame_id').value
        )

        self._last_command: Optional[TwistStamped] = None
        self._last_command_time: Optional[float] = None
        self._last_status: Optional[WalkerStatus] = None
        self._last_status_time: Optional[float] = None
        self._last_terrain: Optional[TerrainStatus] = None
        self._last_terrain_time: Optional[float] = None
        self._last_surface: Optional[SurfaceCondition] = None
        self._last_surface_time: Optional[float] = None
        self._ranges: Dict[str, Dict[str, object]] = {
            'left': {
                'distance': math.nan,
                'valid': False,
                'time': None,
            },
            'right': {
                'distance': math.nan,
                'valid': False,
                'time': None,
            },
        }

        self._output_linear = 0.0
        self._output_angular = 0.0
        self._last_tick_time = self._now_seconds()
        self._last_diagnostic_time = -math.inf
        self._last_log_summary = ''
        self._command_output_suppressed = False
        self._assist_motion_seen = False
        self._assist_idle_expired = False
        self._assist_deadman = False
        self._assist_launch_started = False
        self._assist_deadman_since = self._now_seconds()
        self._active_drive_pwm_cap = self._drive_pwm_cap

        status_qos = QoSProfile(
            history=HistoryPolicy.KEEP_LAST,
            depth=10,
            reliability=ReliabilityPolicy.RELIABLE,
            durability=DurabilityPolicy.VOLATILE,
        )

        self.create_subscription(
            TwistStamped,
            str(self.get_parameter('command_topic').value),
            self._command_callback,
            10,
        )
        self.create_subscription(
            Range,
            str(self.get_parameter('left_range_topic').value),
            lambda msg: self._range_callback('left', msg),
            qos_profile_sensor_data,
        )
        self.create_subscription(
            Range,
            str(self.get_parameter('right_range_topic').value),
            lambda msg: self._range_callback('right', msg),
            qos_profile_sensor_data,
        )
        self.create_subscription(
            WalkerStatus,
            str(self.get_parameter('status_topic').value),
            self._status_callback,
            status_qos,
        )
        self.create_subscription(
            TerrainStatus,
            str(self.get_parameter('terrain_status_topic').value),
            self._terrain_callback,
            status_qos,
        )
        self.create_subscription(
            SurfaceCondition,
            str(self.get_parameter('surface_topic').value),
            self._surface_callback,
            qos_profile_sensor_data,
        )

        self._drive_publisher = self.create_publisher(
            DriveCommand, str(self.get_parameter('drive_command_topic').value), 10)
        self._command_publisher = self.create_publisher(
            TwistStamped,
            str(self.get_parameter('safe_command_topic').value),
            10,
        )
        self._diagnostic_publisher = self.create_publisher(
            DiagnosticArray,
            str(self.get_parameter('diagnostics_topic').value),
            10,
        )
        self._timer = self.create_timer(
            1.0 / self._publish_rate, self._timer_callback
        )

        self.get_logger().info(
            'Safety supervisor ready at %.1f Hz; terrain TOF is %s and '
            'surface perception is %s; slope control is %s'
            % (
                self._publish_rate,
                'required' if self._require_ranges else 'optional',
                'required' if self._require_surface else 'optional',
                'enabled' if self._slope_control_enabled else 'disabled',
            )
        )

    def _now_seconds(self) -> float:
        return self.get_clock().now().nanoseconds * 1.0e-9

    def _command_callback(self, msg: TwistStamped) -> None:
        self._last_command = msg
        self._last_command_time = self._now_seconds()

    def _status_callback(self, msg: WalkerStatus) -> None:
        deadman = bool(msg.deadman)
        if deadman and not self._assist_deadman:
            self._assist_motion_seen = False
            self._assist_idle_expired = False
            self._assist_launch_started = False
            self._assist_deadman_since = self._now_seconds()
        elif not deadman:
            self._assist_motion_seen = False
            self._assist_idle_expired = False
            self._assist_launch_started = False

        speed = float(msg.measured_speed_m_s)
        if (
            deadman
            and bool(msg.new_pulse)
            and bool(msg.speed_valid)
            and math.isfinite(speed)
            and speed > 0.0
        ):
            self._assist_motion_seen = True
            self._assist_idle_expired = False

        self._assist_deadman = deadman
        self._last_status = msg
        self._last_status_time = self._now_seconds()

    def _walking_assist_pwm_cap(self, now: float, command_m_s: float) -> int:
        """Return a hands-on launch/following cap without changing the command."""
        status = self._last_status
        if command_m_s <= 0.0 or status is None or not bool(status.deadman):
            return self._drive_pwm_cap

        # Count the four-second launch window only after an ARMED controller
        # can receive a positive drive target. Waiting to arm or holding a
        # downhill stop must not consume it; one grasp gets one window.
        if bool(status.armed) and not self._assist_launch_started:
            self._assist_launch_started = True
            self._assist_deadman_since = now

        launch_cap = min(self._drive_pwm_cap, _HANDS_ON_PWM)
        if not self._assist_motion_seen:
            if (
                self._assist_idle_expired
                or (
                    self._assist_launch_started
                    and now - self._assist_deadman_since
                    >= _NO_PULSE_ASSIST_TIMEOUT_S
                )
            ):
                self._assist_idle_expired = True
                return 0
            return min(self._drive_pwm_cap, launch_cap + max(0, self._slope_ff_pwm))

        speed = float(status.measured_speed_m_s)
        speed_age = float(status.speed_age)
        valid = (
            bool(status.speed_valid)
            and math.isfinite(speed)
            and speed >= 0.0
            and math.isfinite(speed_age)
            and speed_age >= 0.0
        )
        if not valid or speed_age >= _NO_PULSE_ASSIST_TIMEOUT_S:
            self._assist_motion_seen = False
            self._assist_idle_expired = True
            return 0

        # Firmware retains the last Hall speed for five seconds. Once a new
        # magnet is overdue, distance/age is a decreasing upper bound on the
        # current speed and brings the assist back toward PWM 35 promptly.
        effective_speed = speed
        if speed_age > 0.0:
            effective_speed = min(
                effective_speed,
                _HALL_METERS_PER_PULSE / speed_age,
            )
        speed_fraction = _clamp(
            effective_speed / _NOMINAL_ASSIST_SPEED_M_S,
            0.0,
            1.0,
        )
        base_cap = _HANDS_ON_PWM + (
            _NOMINAL_ASSIST_PWM - _HANDS_ON_PWM
        ) * speed_fraction
        # Preserve the existing uphill feed-forward allowance. All configured
        # PWM, slope, speed and safety limits remain authoritative.
        cap = int(round(base_cap + max(0, self._slope_ff_pwm)))
        return max(launch_cap, min(self._drive_pwm_cap, cap))

    def _terrain_callback(self, msg: TerrainStatus) -> None:
        self._last_terrain = msg
        self._last_terrain_time = self._now_seconds()

    def _surface_callback(self, msg: SurfaceCondition) -> None:
        self._last_surface = msg
        self._last_surface_time = self._now_seconds()

    def _range_callback(self, side: str, msg: Range) -> None:
        distance = float(msg.range)
        minimum = max(0.0, float(msg.min_range))
        maximum = float(msg.max_range)
        valid_limits = math.isfinite(maximum) and maximum > minimum

        if distance == math.inf:
            if valid_limits:
                distance = maximum
                valid = True
            else:
                distance = math.nan
                valid = False
        else:
            valid = (
                math.isfinite(distance)
                and distance >= minimum
                and valid_limits
                and distance <= maximum
            )

        self._ranges[side] = {
            'distance': distance,
            'valid': valid,
            'time': self._now_seconds(),
        }

    @staticmethod
    def _age(now: float, received_at: Optional[float]) -> float:
        if received_at is None:
            return math.inf
        if now < received_at:
            return math.inf
        return now - received_at

    def _status_reasons(self, now: float) -> List[str]:
        if self._last_status is None:
            return ['status_missing']
        if self._age(now, self._last_status_time) > self._status_timeout:
            return ['status_stale']

        status = self._last_status
        reasons: List[str] = []
        if not status.link_ok:
            reasons.append('link_not_ok')
        if status.state == WalkerStatus.STATE_DISCONNECTED:
            reasons.append('disconnected')
        if status.state == WalkerStatus.STATE_SAFE_STOP:
            reasons.append('safe_stop')
        if status.estop or status.state == WalkerStatus.STATE_ESTOP:
            reasons.append('estop')
        if status.watchdog_timeout:
            reasons.append('mcu_watchdog_timeout')
        if status.fault_bits != WalkerStatus.FAULT_NONE:
            reasons.append('mcu_fault')
        if status.state == WalkerStatus.STATE_FAULT:
            reasons.append('fault_state')
        if (
            not status.armed
            or status.state == WalkerStatus.STATE_DISARMED
        ):
            reasons.append('disarmed')
        if status.state not in (
            WalkerStatus.STATE_ARMED,
            WalkerStatus.STATE_DISCONNECTED,
            WalkerStatus.STATE_DISARMED,
            WalkerStatus.STATE_SAFE_STOP,
            WalkerStatus.STATE_ESTOP,
            WalkerStatus.STATE_FAULT,
        ):
            reasons.append('invalid_state')
        if self._require_deadman and not status.deadman:
            reasons.append('deadman_released')

        telemetry_age = float(status.telemetry_age)
        if (
            not math.isfinite(telemetry_age)
            or telemetry_age < 0.0
            or telemetry_age > self._max_telemetry_age
        ):
            reasons.append('telemetry_stale')
        return reasons

    def _command_reasons(self, now: float) -> List[str]:
        if self._last_command is None:
            return ['command_missing']
        if self._age(now, self._last_command_time) > self._command_timeout:
            return ['command_stale']
        linear = float(self._last_command.twist.linear.x)
        angular = float(self._last_command.twist.angular.z)
        if not math.isfinite(linear) or not math.isfinite(angular):
            return ['command_nonfinite']
        if abs(angular) > self._max_angular:
            return ['angular_command_unsupported']
        return []

    def _terrain_reasons(self, now: float) -> List[str]:
        # Invalid measurements report diagnostics only; they neither initiate
        # a stop nor prove that a previously confirmed hazard has disappeared.
        if not self.get_parameter('terrain_stop_enabled').value:
            self._terrain_stopping = False
            self._terrain_note = ''
            return []
        terrain = self._last_terrain
        age = float(terrain.telemetry_age) if terrain is not None else math.inf
        valid = (
            terrain is not None and self._last_terrain_time is not None
            and math.isfinite(age) and age >= 0.0
            and 0.0 <= self._age(now, self._last_terrain_time) <= self._range_timeout
            and age + self._age(now, self._last_terrain_time) <= self._max_telemetry_age
            and terrain.tof_valid
            and terrain.tof_alert in (TerrainStatus.TOF_NORMAL,
                TerrainStatus.TOF_CANDIDATE_RAISED, TerrainStatus.TOF_CANDIDATE_DROP,
                TerrainStatus.TOF_RAISED, TerrainStatus.TOF_DROP)
            and not (terrain.fault_bits & TerrainStatus.FAULT_TOF_INVALID)
        )
        self._terrain_note = '' if valid else 'terrain_tof_unavailable'
        if valid and terrain.tof_alert in (TerrainStatus.TOF_RAISED, TerrainStatus.TOF_DROP):
            if not self._terrain_stopping:
                self._terrain_stop_started = now
            self._terrain_stopping = True
            self._terrain_clear_since = None
        elif valid and terrain.tof_alert == TerrainStatus.TOF_NORMAL:
            if self._terrain_clear_since is None:
                self._terrain_clear_since = now
            if (now - self._terrain_clear_since >= 0.5
                    and now - self._terrain_stop_started >= 3.1):
                self._terrain_stopping = False
        else:
            self._terrain_clear_since = None
        # TODO(display): show warning while _terrain_stopping; use
        # /terrain/status and /diagnostics. A single oblique beam cannot locate
        # the edge at 40/15 cm, so confirmed hazards start the ramp immediately.
        return []

    def _slope_state(
        self, now: float
    ) -> Tuple[float, str, float]:
        if not self._slope_control_enabled:
            self._slope_policy.reset()
            return 1.0, 'disabled', math.nan

        terrain = self._last_terrain
        sample_valid = bool(
            terrain is not None
            and self._age(now, self._last_terrain_time)
            <= self._range_timeout
            and math.isfinite(float(terrain.telemetry_age))
            and float(terrain.telemetry_age) >= 0.0
            and 0.0 <= float(terrain.telemetry_age) + self._age(now, self._last_terrain_time)
            <= self._range_timeout
            and terrain.mpu_valid
            and not (
                terrain.fault_bits & TerrainStatus.FAULT_MPU_INVALID
            )
            and math.isfinite(float(terrain.pitch_rad))
        )
        pitch_rad = (
            float(terrain.pitch_rad) if terrain is not None else math.nan
        )
        scale, state, normalized_pitch = self._slope_policy.update(
            pitch_rad=pitch_rad,
            sample_valid=sample_valid,
            now_s=now,
        )
        if not sample_valid:
            state = 'unavailable'
        return scale, state, normalized_pitch

    def _range_scale(self, distance: float) -> float:
        if distance <= self._stop_distance:
            return 0.0
        if distance >= self._slow_distance:
            return 1.0
        return (
            (distance - self._stop_distance)
            / (self._slow_distance - self._stop_distance)
        )

    def _range_state(
        self, now: float
    ) -> Tuple[List[str], Dict[str, float], Dict[str, float]]:
        reasons: List[str] = []
        distances = {'left': math.nan, 'right': math.nan}
        scales = {'left': 1.0, 'right': 1.0}
        if not self.get_parameter('range_control_enabled').value:
            return reasons, distances, scales

        for side in ('left', 'right'):
            sample = self._ranges[side]
            sample_time = sample['time']
            fresh = (
                sample_time is not None
                and self._age(now, sample_time) <= self._range_timeout
            )
            valid = bool(sample['valid'])

            if not fresh or not valid:
                # Front-facing ranges are optional. require_range_sensors now
                # refers to the installed downward TOF TerrainStatus stream.
                continue

            distance = float(sample['distance'])
            distances[side] = distance
            scales[side] = self._range_scale(distance)

        return reasons, distances, scales

    def _surface_state(
        self, now: float
    ) -> Tuple[List[str], float, int, float]:
        if not self._surface_control_enabled:
            return [], 1.0, SurfaceCondition.UNKNOWN, math.nan
        if self._last_surface is None:
            reasons = ['surface_missing'] if self._require_surface else []
            return reasons, 1.0, SurfaceCondition.UNKNOWN, math.nan
        if self._age(now, self._last_surface_time) > self._surface_timeout:
            reasons = ['surface_stale'] if self._require_surface else []
            return reasons, 1.0, SurfaceCondition.UNKNOWN, math.nan

        surface = self._last_surface
        confidence = float(surface.confidence)
        scale = float(surface.recommended_speed_scale)
        known_classifications = {
            SurfaceCondition.SMOOTH,
            SurfaceCondition.ROUGH,
            SurfaceCondition.WET,
            SurfaceCondition.GRAVEL,
            SurfaceCondition.STEP,
            SurfaceCondition.HOLE,
        }
        valid = (
            bool(surface.valid)
            and surface.classification in known_classifications
            and math.isfinite(confidence)
            and 0.0 <= confidence <= 1.0
            and math.isfinite(scale)
            and 0.0 <= scale <= self._max_surface_scale
        )
        if not valid:
            reasons = ['surface_invalid'] if self._require_surface else []
            return reasons, 1.0, surface.classification, confidence
        return [], scale, surface.classification, confidence

    @staticmethod
    def _slew(
        current: float,
        target: float,
        acceleration: float,
        deceleration: float,
        dt: float,
    ) -> float:
        gaining_speed = (
            current == 0.0
            or (current * target > 0.0 and abs(target) > abs(current))
        )
        rate = acceleration if gaining_speed else deceleration
        max_change = max(0.0, rate) * max(0.0, dt)
        return current + _clamp(target - current, -max_change, max_change)

    def _desired_command(
        self,
        range_scales: Dict[str, float],
        surface_scale: float,
        slope_scale: float,
        slope_state: str,
    ) -> Tuple[float, float, List[str]]:
        assert self._last_command is not None
        requested_linear = float(self._last_command.twist.linear.x)
        requested_angular = float(self._last_command.twist.angular.z)

        finite_input = (
            math.isfinite(requested_linear)
            and math.isfinite(requested_angular)
        )
        if not finite_input:
            return 0.0, 0.0, ['nonfinite_command']
        linear = _clamp(
            requested_linear, -self._max_reverse, self._max_forward
        )
        angular = _clamp(
            requested_angular, -self._max_angular, self._max_angular
        )

        limiting_scale = 1.0
        if linear > 0.0:
            limiting_scale = min(
                range_scales['left'], range_scales['right']
            )
            linear *= limiting_scale

        turn_scale = 1.0
        if angular != 0.0:
            # With only two forward-looking sensors, either side can sweep
            # into an obstacle during a turn.  Be conservative until a full
            # footprint-aware collision monitor is available.
            turn_scale = min(
                range_scales['left'], range_scales['right']
            )
            angular *= turn_scale

        # Pitch sign is defined in the forward vehicle frame. Do not interpret
        # an uphill chassis attitude as assist while commanding reverse.
        effective_slope_scale = slope_scale if requested_linear > 0.0 else 1.0
        combined_speed_scale = combine_speed_scales(
            surface_scale,
            effective_slope_scale,
            self._max_combined_speed_scale,
        )
        linear *= combined_speed_scale
        angular *= combined_speed_scale
        linear = _clamp(linear, -self._max_reverse, self._max_forward)
        angular = _clamp(angular, -self._max_angular, self._max_angular)

        notes: List[str] = []
        active_scale = min(
            limiting_scale,
            turn_scale,
        )
        if active_scale <= 0.0 and (
            requested_linear > 0.0 or requested_angular != 0.0
        ):
            notes.append('obstacle_stop')
        elif active_scale < 1.0:
            notes.append('obstacle_slowdown')
        if surface_scale <= 0.0 and (
            requested_linear != 0.0 or requested_angular != 0.0
        ):
            notes.append('surface_stop')
        elif surface_scale < 1.0:
            notes.append('surface_slowdown')
        elif surface_scale > 1.0:
            notes.append('surface_speedup')
        if (
            slope_state == SlopeSpeedPolicy.DOWNHILL
            and requested_linear > 0.0
            and slope_scale < 1.0
        ):
            notes.append('downhill_slowdown')
        elif (
            slope_state == SlopeSpeedPolicy.UPHILL
            and requested_linear > 0.0
        ):
            notes.append(
                'uphill_assist'
                if combined_speed_scale > 1.0
                else 'uphill_assist_limited'
            )

        return linear, angular, notes

    def _timer_callback(self) -> None:
        now = self._now_seconds()
        dt = now - self._last_tick_time
        if dt <= 0.0 or dt > 1.0:
            dt = 1.0 / self._publish_rate
        self._last_tick_time = now

        hard_stop_reasons = self._command_reasons(now)
        hard_stop_reasons.extend(self._status_reasons(now))
        hard_stop_reasons.extend(self._terrain_reasons(now))
        range_reasons, distances, range_scales = self._range_state(now)
        hard_stop_reasons.extend(range_reasons)
        (
            surface_reasons,
            surface_scale,
            surface_classification,
            surface_confidence,
        ) = self._surface_state(now)
        hard_stop_reasons.extend(surface_reasons)
        slope_scale, slope_state, normalized_pitch = self._slope_state(now)
        self._slope_braking = self._brake_policy.update(
            normalized_pitch, now, self._slope_control_enabled)
        # The 5-degree display classification must not bypass the stop threshold.
        downhill_pwm_off = self._slope_braking and math.isfinite(normalized_pitch)
        self._slope_ff_pwm = slope_feedforward_pwm(normalized_pitch, slope_state)
        if (self._slope_ff_pwm > 0 and normalized_pitch <
                float(self.get_parameter('slope_enter_angle_rad').value)):
            self._slope_ff_pwm = 0
        combined_speed_scale = combine_speed_scales(
            surface_scale,
            slope_scale,
            self._max_combined_speed_scale,
        )
        motion_stop_reasons = [
            reason for reason in hard_stop_reasons
            if reason != 'disarmed'
        ]

        operating_notes: List[str] = []
        if motion_stop_reasons:
            # Stale or unsafe state must never coast on the last valid command.
            self._output_linear = 0.0
            self._output_angular = 0.0
        else:
            desired_linear, desired_angular, operating_notes = (
                self._desired_command(
                    range_scales,
                    surface_scale,
                    slope_scale,
                    slope_state,
                )
            )
            if (
                'obstacle_stop' in operating_notes
                or 'surface_stop' in operating_notes
            ):
                # Hazard entry is immediate; a valid clear result is required
                # before motion can resume.
                self._output_linear = 0.0
                self._output_angular = 0.0
            else:
                self._output_linear = self._slew(
                    self._output_linear,
                    desired_linear,
                    self._linear_accel,
                    self._linear_decel,
                    dt,
                )
                self._output_angular = self._slew(
                    self._output_angular,
                    desired_angular,
                    self._angular_accel,
                    self._angular_decel,
                    dt,
                )

        if downhill_pwm_off:
            self._output_linear = self._output_angular = 0.0
            operating_notes.append('downhill_pwm_off')

        if self._slope_braking:
            self._output_linear = self._output_angular = 0.0
            operating_notes.append('slope_ramp_stop' if math.isfinite(normalized_pitch) else 'imu_brake')

        if self._terrain_note:
            operating_notes.append(self._terrain_note)
        if self._terrain_stopping:
            self._output_linear = self._output_angular = 0.0
            operating_notes.append('terrain_hazard_ramp_or_brake')

        # Keep forwarding a valid supervised command while DISARMED so the
        # automatic bridge can activate the controller as soon as the
        # physical dead-man input is active. Other invalid or stale inputs
        # publish one immediate zero and then go silent, forcing the bridge
        # timeout to disarm the MCU.
        may_stream_command = (
            not hard_stop_reasons
            or set(hard_stop_reasons).issubset({'disarmed'})
        )
        if may_stream_command or not self._command_output_suppressed:
            output = TwistStamped()
            output.header.stamp = self.get_clock().now().to_msg()
            output.header.frame_id = self._output_frame_id
            output.twist.linear.x = self._output_linear
            output.twist.angular.z = self._output_angular
            self._command_publisher.publish(output)
            drive = DriveCommand()
            drive.header = output.header
            drive.target_linear_m_s = self._output_linear
            drive.target_speed_kmh = self._output_linear * 3.6
            self._active_drive_pwm_cap = self._walking_assist_pwm_cap(
                now, self._output_linear
            )
            drive.drive_pwm_cap = self._active_drive_pwm_cap
            drive.mode = DriveCommand.BRAKE if (
                (self._slope_braking and not math.isfinite(normalized_pitch)) or motion_stop_reasons or
                'obstacle_stop' in operating_notes or 'surface_stop' in operating_notes
            ) else DriveCommand.DRIVE
            # All valid downhill stops use the same actuator fade; confirmed
            # slope classification must not interrupt it with an immediate brake.
            if (downhill_pwm_off or self._terrain_stopping or self._slope_braking) and drive.mode == DriveCommand.DRIVE:
                drive.mode = DriveCommand.TERRAIN_STOP
            drive.slope_ff_pwm = self._slope_ff_pwm if (
                drive.mode == DriveCommand.DRIVE and self._output_linear > 0.0
            ) else 0
            self._drive_publisher.publish(drive)
        self._command_output_suppressed = not may_stream_command

        all_reasons = hard_stop_reasons + operating_notes
        summary = ', '.join(all_reasons) if all_reasons else 'ready'
        if summary != self._last_log_summary:
            if hard_stop_reasons:
                self.get_logger().warning('Motion inhibited: ' + summary)
            elif operating_notes:
                self.get_logger().warning('Motion limited: ' + summary)
            else:
                self.get_logger().info('Motion supervision ready')
            self._last_log_summary = summary

        if now - self._last_diagnostic_time >= 1.0 / self._diagnostic_rate:
            self._publish_diagnostics(
                now,
                hard_stop_reasons,
                operating_notes,
                distances,
                range_scales,
                surface_scale,
                surface_classification,
                surface_confidence,
                slope_scale,
                slope_state,
                normalized_pitch,
                combined_speed_scale,
            )
            self._last_diagnostic_time = now

    def _publish_diagnostics(
        self,
        now: float,
        hard_stop_reasons: List[str],
        operating_notes: List[str],
        distances: Dict[str, float],
        range_scales: Dict[str, float],
        surface_scale: float,
        surface_classification: int,
        surface_confidence: float,
        slope_scale: float,
        slope_state: str,
        normalized_pitch: float,
        combined_speed_scale: float,
    ) -> None:
        diagnostic = DiagnosticStatus()
        diagnostic.name = 'SafeStride/Safety Supervisor'
        diagnostic.hardware_id = 'safestride'

        severe = {
            'estop',
            'mcu_fault',
            'fault_state',
            'mcu_watchdog_timeout',
            'link_not_ok',
            'disconnected',
            'invalid_state',
            'status_stale',
            'telemetry_stale',
            'command_nonfinite',
            'surface_missing',
            'surface_stale',
            'surface_invalid',
            'terrain_status_missing',
            'terrain_status_stale',
            'terrain_telemetry_stale',
            'terrain_tof_invalid',
            'terrain_raised_obstacle',
            'terrain_drop',
            'terrain_alert_invalid',
            'terrain_tof_fault',
        }
        if any(reason in severe for reason in hard_stop_reasons):
            diagnostic.level = DiagnosticStatus.ERROR
        elif hard_stop_reasons or operating_notes:
            diagnostic.level = DiagnosticStatus.WARN
        else:
            diagnostic.level = DiagnosticStatus.OK

        all_reasons = hard_stop_reasons + operating_notes
        diagnostic.message = ', '.join(all_reasons) if all_reasons else 'ready'
        status = self._last_status
        diagnostic.values = [
            KeyValue(key='brake_enter_deg', value=str(self._brake_policy.enter)),
            KeyValue(key='brake_release_deg', value=str(self._brake_policy.release)),
            KeyValue(key='uphill_pitch_sign', value=str(self.get_parameter('uphill_pitch_sign').value)),
            KeyValue(key='raw_pitch_deg', value=str(
                math.degrees(self._last_terrain.pitch_rad) if self._last_terrain else math.nan)),
            KeyValue(key='drive_mode', value='BRAKE' if (
                (self._slope_control_enabled and slope_state == SlopeSpeedPolicy.DOWNHILL)
                or (self._slope_braking and not math.isfinite(normalized_pitch))
                or any(reason != 'disarmed' for reason in hard_stop_reasons)
                or 'obstacle_stop' in operating_notes or 'surface_stop' in operating_notes)
                else ('TERRAIN_STOP' if self._terrain_stopping or self._slope_braking else 'DRIVE')),
            KeyValue(key='slope_ff_pwm', value=str(self._slope_ff_pwm)),
            KeyValue(
                key='active_drive_pwm_cap',
                value=str(self._active_drive_pwm_cap),
            ),
            KeyValue(
                key='walking_assist_motion_seen',
                value=_bool_text(self._assist_motion_seen),
            ),
            KeyValue(key='surface_control_enabled', value=_bool_text(self._surface_control_enabled)),
            KeyValue(key='slope_restart_latched', value='false'),
            KeyValue(key='ff_pwm', value=str(status.ff_pwm if status else 0)),
            KeyValue(key='feedback_pwm', value=str(status.feedback_pwm if status else 0)),
            KeyValue(key='applied_pwm', value=str(status.applied_pwm if status else 0)),
            KeyValue(key='speed_valid', value=_bool_text(bool(status and status.speed_valid))),
            KeyValue(key='speed_age_s', value=str(status.speed_age if status else math.inf)),
            KeyValue(key='direction_valid', value='false'),
            KeyValue(key='measured_speed_m_s', value=str(status.measured_speed_m_s if status else math.nan)),
            KeyValue(key='measured_speed_kmh', value=str(status.measured_speed_m_s * 3.6 if status else math.nan)),
            KeyValue(key='output_speed_kmh', value=str(self._output_linear * 3.6)),
            KeyValue(key='mcu_braking', value=_bool_text(bool(status and status.braking))),
            KeyValue(
                key='motion_inhibited',
                value=_bool_text(bool(hard_stop_reasons)),
            ),
            KeyValue(
                key='command_output_suppressed',
                value=_bool_text(self._command_output_suppressed),
            ),
            KeyValue(
                key='command_age_s',
                value='%.3f' % self._age(now, self._last_command_time),
            ),
            KeyValue(
                key='status_age_s',
                value='%.3f' % self._age(now, self._last_status_time),
            ),
            KeyValue(
                key='left_range_m',
                value=(
                    'unavailable'
                    if math.isnan(distances['left'])
                    else '%.3f' % distances['left']
                ),
            ),
            KeyValue(
                key='right_range_m',
                value=(
                    'unavailable'
                    if math.isnan(distances['right'])
                    else '%.3f' % distances['right']
                ),
            ),
            KeyValue(
                key='left_range_scale',
                value='%.3f' % range_scales['left'],
            ),
            KeyValue(
                key='right_range_scale',
                value='%.3f' % range_scales['right'],
            ),
            KeyValue(
                key='surface_required',
                value=_bool_text(self._require_surface),
            ),
            KeyValue(
                key='surface_age_s',
                value='%.3f' % self._age(now, self._last_surface_time),
            ),
            KeyValue(
                key='surface_classification',
                value=str(surface_classification),
            ),
            KeyValue(
                key='surface_confidence',
                value=(
                    'unavailable'
                    if not math.isfinite(surface_confidence)
                    else '%.3f' % surface_confidence
                ),
            ),
            KeyValue(
                key='surface_speed_scale',
                value='%.3f' % surface_scale,
            ),
            KeyValue(
                key='slope_control_enabled',
                value=_bool_text(self._slope_control_enabled),
            ),
            KeyValue(key='slope_state', value=slope_state),
            KeyValue(
                key='slope_pitch_rad',
                value=(
                    'unavailable'
                    if not math.isfinite(normalized_pitch)
                    else '%.4f' % normalized_pitch
                ),
            ),
            KeyValue(
                key='slope_speed_scale',
                value='%.3f' % slope_scale,
            ),
            KeyValue(
                key='combined_forward_speed_scale',
                value='%.3f' % combined_speed_scale,
            ),
            KeyValue(
                key='output_linear_mps',
                value='%.3f' % self._output_linear,
            ),
            KeyValue(
                key='output_angular_radps',
                value='%.3f' % self._output_angular,
            ),
            KeyValue(
                key='fault_bits',
                value='0x%04x' % (status.fault_bits if status else 0),
            ),
            KeyValue(
                key='mcu_state',
                value=str(status.state if status else -1),
            ),
            KeyValue(
                key='link_ok',
                value=_bool_text(bool(status and status.link_ok)),
            ),
            KeyValue(
                key='armed',
                value=_bool_text(bool(status and status.armed)),
            ),
            KeyValue(
                key='deadman',
                value=_bool_text(bool(status and status.deadman)),
            ),
            KeyValue(
                key='estop',
                value=_bool_text(bool(status and status.estop)),
            ),
            KeyValue(
                key='watchdog_timeout',
                value=_bool_text(bool(status and status.watchdog_timeout)),
            ),
            KeyValue(
                key='telemetry_age_s',
                value=(
                    'unavailable'
                    if status is None
                    else '%.3f' % status.telemetry_age
                ),
            ),
            KeyValue(
                key='boot_id',
                value=str(status.boot_id if status else 0),
            ),
            KeyValue(
                key='session_id',
                value=str(status.session_id if status else 0),
            ),
            KeyValue(
                key='last_applied_command_sequence',
                value=str(
                    status.last_applied_command_sequence if status else 0
                ),
            ),
            KeyValue(
                key='crc_error_count',
                value=str(status.crc_error_count if status else 0),
            ),
            KeyValue(
                key='frame_error_count',
                value=str(status.frame_error_count if status else 0),
            ),
        ]

        array = DiagnosticArray()
        array.header.stamp = self.get_clock().now().to_msg()
        array.status = [diagnostic]
        self._diagnostic_publisher.publish(array)


def main(args=None) -> None:
    rclpy.init(args=args)
    node = SafetySupervisor()
    try:
        rclpy.spin(node)
    except KeyboardInterrupt:
        pass
    finally:
        # A launch SIGINT may already have invalidated the ROS context before
        # spin returns. Publish the final zero only while the publisher can
        # still be used; the serial bridge independently stops on shutdown.
        if rclpy.ok():
            stop = TwistStamped()
            stop.header.stamp = node.get_clock().now().to_msg()
            stop.header.frame_id = node._output_frame_id
            node._command_publisher.publish(stop)
        node.destroy_node()
        if rclpy.ok():
            rclpy.shutdown()


if __name__ == '__main__':
    main()
