Hanjingyu625/SafeStride/src/safestride_bringup/config/safestride.yaml

serial_bridge:
  ros__parameters:
    serial:
      port: /dev/serial/by-id/CHANGE_ME
      baudrate: 115200
      read_chunk_size: 256
      max_frame_size: 160
      reconnect_period_s: 1.0
    transport:
      # Drive telemetry is 50 Hz; 100 Hz polling leaves serial and CPU margin.
      poll_rate_hz: 100.0
    command:
      publish_rate_hz: 50.0
      # Allow short Pi scheduling stalls without dropping the 20 Hz cruise
      # stream. The MCU still enforces its independent 200 ms frame TTL.
      timeout_s: 0.50
      ttl_ms: 200
      # Use /cmd_vel_safe and the Hall-speed PID instead of fixed PWM drive.
      deadman_direct_drive: false
      deadman_forward_velocity_m_s: 0.10
      # Calibration state remains diagnostic; pulse feedback and stall checks
      # are still active in the closed-loop firmware.
      require_hall_calibration: false
      max_abs_angular_z_rad_s: 0.0
      allow_magnet_bench_mode: false
      auto_arm_magnet_bench_mode: false
    telemetry:
      timeout_s: 0.30
    diagnostics:
      publish_rate_hz: 1.0
    # Wheel radius/separation come from the launch arguments so URDF and
    # bridge kinematics cannot diverge.
    base:
      hall_pulses_per_revolution: 12
      max_wheel_speed_rad_s: 10.0
    range:
      min_m: 0.02
      max_m: 4.0
      field_of_view_rad: 0.35
    battery:
      nominal_voltage: 12.0
      empty_voltage: 0.0
      full_voltage: 0.0
    frames:
      odom: odom
      base: base_footprint
      range_left: front_left_range_link
      range_right: front_right_range_link
    joints:
      left: left_wheel_joint
      right: right_wheel_joint
    topics:
      cmd_vel: /cmd_vel_safe
      joint_states: /joint_states
      odom: /odom
      range_left: /range/front_left
      range_right: /range/front_right
      battery: /battery_state
      pressure: /handle/pressure
      hall: /wheel/hall
      status: /walker/status
      diagnostics: /diagnostics
    services:
      set_enabled: /walker/set_enabled
    publish_tf: true

terrain_bridge:
  ros__parameters:
    # Level reference: pitch -6.646310 deg, roll -3.380451 deg.
    # Applied to /terrain/status only; /terrain/imu remains in the sensor frame.
    attitude:
      pitch_offset_rad: -0.116
      roll_offset_rad: -0.059
    hmi:
      enabled: true
      pitch_sign: -1.0  # Match safety_supervisor.uphill_pitch_sign.
      pitch_offset_rad: 0.0  # Match safety_supervisor.pitch_offset_rad.
      topics:
        surface: /perception/surface_condition
    serial:
      port: /dev/serial/by-id/CHANGE_ME_TERRAIN_UNO
      baudrate: 115200
      read_chunk_size: 256
      max_frame_size: 160
      reconnect_period_s: 1.0
    transport: {poll_rate_hz: 100.0}
    telemetry: {timeout_s: 0.30}
    diagnostics: {publish_rate_hz: 1.0}
    range: {min_m: 0.10, max_m: 2.0, field_of_view_rad: 0.052}
    frames: {tof: terrain_tof_link, imu: imu_link}
    topics:
      tof: /terrain/tof
      imu: /terrain/imu
      status: /terrain/status
      diagnostics: /diagnostics

safety_supervisor:
  ros__parameters:
    publish_rate: 20.0
    diagnostic_rate: 2.0
    command_timeout: 0.50
    status_timeout: 0.50
    max_telemetry_age: 0.50
    range_timeout: 0.35
    # TOF is telemetry-only on the current hardware; MPU slope assistance stays
    # active, and an invalid MPU sample falls back to a neutral speed scale.
    range_control_enabled: false  # No front-range motor slowdown/stop
    require_range_sensors: false
    terrain_stop_enabled: false  # ToF telemetry only; no motor stop
    require_surface_condition: false
    surface_control_enabled: false
    drive_command_topic: /drive/command
    brake_enter_deg: 7.0  # Begin the 3 s actuator PWM fade at threshold entry.
    brake_release_deg: 3.0
    brake_recovery_s: 0.5
    drive_pwm_cap: 140
    require_deadman: true
    slope_control_enabled: true

    # Conservative first-test limits. Raise only after logging and validation.
    max_forward_velocity: 1.15
    max_reverse_velocity: 0.08
    max_angular_velocity: 0.0
    max_linear_acceleration: 0.50
    max_linear_deceleration: 0.50
    max_angular_acceleration: 0.50
    max_angular_deceleration: 1.00
    # Flip to -1.0 if lifting the walker front makes pitch_rad negative.
    uphill_pitch_sign: -1.0
    # Terrain status is already zeroed by terrain_bridge; do not subtract twice.
    pitch_offset_rad: 0.0
    slope_enter_angle_rad: 0.08726646259971647  # 5 deg
    slope_exit_angle_rad: 0.05235987755982989  # 3 deg
    slope_confirmation_time_s: 0.50
    downhill_speed_scale: 1.0  # TERRAIN_STOP fades actual PWM to zero over 3 s.
    uphill_speed_scale: 1.0
    max_combined_speed_scale: 1.25

    stop_distance: 0.35
    slow_distance: 0.80

    command_topic: /cmd_vel
    safe_command_topic: /cmd_vel_safe
    left_range_topic: /range/front_left
    right_range_topic: /range/front_right
    status_topic: /walker/status
    terrain_status_topic: /terrain/status
    diagnostics_topic: /diagnostics
    output_frame_id: base_link

cruise_command:
  ros__parameters:
    speed_mps: 1.0
    minimum_speed_mps: 0.0
    maximum_speed_mps: 1.15
    push_speed_step_mps: 0.03
    pull_speed_step_mps: 0.05
    push_repeat_s: 0.40
    pull_repeat_s: 0.30
    hall_delta_threshold_mps: 0.05
    imu_delta_velocity_threshold_mps: 0.03
    feedback_threshold_pwm: 3.0
    intent_window_s: 0.50
    target_proximity_mps: 0.05
    maximum_learning_pitch_deg: 3.0
    status_timeout_s: 0.50
    hall_speed_max_age_s: 0.75
    imu_timeout_s: 0.30
    terrain_timeout_s: 0.35
    drive_command_timeout_s: 0.50
    gps_timeout_s: 2.0
    gps_disagreement_mps: 0.40
    gps_disagreement_hold_s: 2.0
    imu_forward_sign: 1.0
    publish_rate_hz: 20.0
    status_topic: /walker/status
    imu_topic: /terrain/imu
    terrain_topic: /terrain/status
    gps_speed_topic: /gps/speed
    drive_command_topic: /drive/command
    command_topic: /cmd_vel
    frame_id: base_link

surface_perception:
  ros__parameters:
    camera:
      device: ''  # Optional /dev/v4l/by-id/... path; overrides index.
      index: 0
      backend: v4l2
      width: 640
      height: 480
      reconnect_period_s: 2.0
      compressed_topic: /camera/image/compressed
      jpeg_quality: 70
    model:
      path: ''
      classes_path: ''
      confidence_threshold: 0.55
      min_top1_margin: 0.08
      ema_alpha: 0.75
      cpu_threads: 1
      version: ''
    inference_rate_hz: 1.0
    diagnostic_rate_hz: 1.0
    surface_topic: /perception/surface_condition
    diagnostics_topic: /diagnostics
    frame_id: camera_link

gps_node:
  ros__parameters:
    # BE-220 is connected directly to the Raspberry Pi, not the Terrain Uno.
    port: /dev/serial0
    baudrate: 115200
    poll_rate_hz: 50.0
    reconnect_period_s: 1.0
    frame_id: gps_link
    fix_topic: /gps/fix
    speed_topic: /gps/speed
    raw_speed_topic: /gps/speed_raw
    course_topic: /gps/course
    diagnostics_topic: /diagnostics
    nmea_timeout_s: 2.0
    fix_timeout_s: 2.0
    diagnostic_rate_hz: 1.0
    course_min_speed_mps: 0.20
    # GPS is a fallback. Hall odometry remains authoritative for walking speed.
    speed_filter_window_s: 8.0
    # Ignore receiver-acquisition transients after startup or reconnect.
    speed_filter_settling_time_s: 15.0
    speed_filter_minimum_span_s: 4.0
    speed_filter_minimum_samples: 5
    speed_filter_minimum_displacement_m: 1.0
    speed_filter_hdop_displacement_scale_m: 0.50
    speed_filter_minimum_path_efficiency: 0.55
    speed_filter_minimum_course_coherence: 0.55
    # Reject coherent GNSS position drift when RMC Doppler speed disagrees.
    speed_filter_minimum_speed_agreement: 0.60
    speed_filter_maximum_hdop: 5.0
    speed_filter_minimum_satellites: 5
    speed_filter_require_quality: true
    speed_filter_enter_confirmations: 2
    speed_filter_exit_confirmations: 3
    speed_filter_smoothing_alpha: 0.35
    speed_filter_maximum_speed_mps: 3.0


crosswalk_controller:
  ros__parameters:
    crosswalk_file: ''
    api_key_file: ''
    signal_url: https://t-data.seoul.go.kr/apig/apiman-gateway/tapi/v2xSignalPhaseTimingCurrentInfo/1.0
    signal_phase_url: https://t-data.seoul.go.kr/apig/apiman-gateway/tapi/v2xSignalPhaseCurrentInfo/1.0
    signal_combined_url: ''
    # Optional bench fallback. Live GPS/V2X matching takes priority.
    intersection_id: ''
    intersection_map_page_size: 100
    intersection_map_max_pages: 30
    intersection_map_retry_s: 60.0
    intersection_map_file: ''
    intersection_map_cache_file: ~/.cache/safestride/v2x_intersections.json
    maximum_intersection_distance_m: 120.0
    update_rate_hz: 5.0
    gps_timeout_s: 2.0
    speed_timeout_s: 1.0
    heading_timeout_s: 5.0
    heading_min_move_m: 2.0
    heading_max_step_m: 30.0
    candidate_heading_tolerance_deg: 60.0  # 유효 진행방향과 횡단축·중심방위의 최대 오차(도); 방향 없으면 거리 선택
    gps_change_threshold_m: 0.5
    gps_stuck_timeout_s: 5.0
    gps_stuck_speed_mps: 0.15
    wheel_motion_min_speed_mps: 0.02
    wheel_motion_hold_s: 3.5
    # Hall odometry is required; GNSS alone cannot verify very slow motion.
    allow_gps_speed_fallback: false
    signal_refresh_interval_s: 3.0  # 일반 실패·누락 재시도 간격; API 0초 응답은 별도로 2초 간격 최대 3회 추가 조회
    signal_cache_max_age_s: 12.0  # 최초 응답 수용 시 원본 나이 상한; 수용 후 해당 현시 종료까지 계산
    signal_request_timeout_s: 3.0
    maximum_crosswalk_distance_m: 80.0
    default_safe_speed_mps: 1.00
    # Match safety_supervisor.max_forward_velocity and the MCU wheel limit.
    maximum_assist_speed_mps: 1.15
    reaction_time_s: 1.0
    entry_safety_margin_s: 2.0
    profile_file: ''
    # Enable only after logged Pi-only tests and lifted-wheel validation.
    motion_output_enabled: false
    fix_topic: /gps/fix
    gps_speed_topic: /gps/speed
    gps_course_topic: /gps/course
    odom_topic: /odom
    command_topic: /cmd_vel
    status_topic: /crosswalk/status
    diagnostics_topic: /diagnostics
    output_frame_id: base_link

foxglove_bridge:
  ros__parameters:
    port: 8765
    address: 0.0.0.0
    topic_whitelist:
      - ^/(diagnostics|walker/status|wheel/hall|handle/pressure|battery_state)$
      - ^/terrain/(tof|imu|status|pitch_deg|roll_deg|light/(adc|requested_on|output_enabled))$
      - ^/(gps/fix|gps/speed|gps/speed_kmh|gps/speed_raw|gps/speed_raw_kmh|gps/course|crosswalk/status|odom|odom_kmh|cmd_vel_kmh|cmd_vel_safe_kmh|tf|tf_static|robot_description)$
      - ^/perception/surface_condition$
      - ^/camera/image/compressed$
    service_whitelist: ['(?!)']
    param_whitelist: ['(?!)']
    client_topic_whitelist: ['(?!)']
    capabilities: [connectionGraph, assets]
    sysinfo: true
