Hanjingyu625/SafeStride/firmware/terrain_mcu/config.h

// Terrain Uno의 I2C 주소, 주기, 거리 판정과 자세 필터 설정.
// ToF 기준 거리 학습과 위험 확정은 별개이며, 센서 유효성은 telemetry로 Pi에 전달한다.

#pragma once

#include <Arduino.h>

namespace safestride_terrain_config {

constexpr uint32_t SERIAL_BAUD = 115200UL;
constexpr uint16_t HELLO_PERIOD_MS = 500U;
constexpr uint16_t TELEMETRY_PERIOD_MS = 50U;
constexpr uint16_t SESSION_LOSS_TIMEOUT_MS = 1500U;
constexpr int AVR_BOOT_COUNTER_EEPROM_ADDRESS = 8;

// CdS on A0, 1-channel 5V relay IN on D4, COM/NO contacts.
// HIGH = ON per EDUINO D-41 seller example; verify on the installed module.
// SRD-05VDC-SL-C names the relay body, not its module's trigger polarity.
// Thresholds are provisional ADC counts, not lux or field-calibrated values.
constexpr uint8_t LIGHT_SENSOR_PIN = A0;
constexpr int8_t LIGHT_RELAY_PIN = 4;
constexpr int8_t LIGHT_RELAY_ON_LEVEL = HIGH;
constexpr bool LIGHT_OUTPUT_ENABLED = true;
// Divider: 5V -- CdS -- A0 -- 10 kohm -- GND.
constexpr bool LIGHT_BRIGHT_IS_HIGH = true;
constexpr uint16_t LIGHT_ON_BRIGHTNESS = 350U;
constexpr uint16_t LIGHT_OFF_BRIGHTNESS = 550U;
constexpr uint16_t LIGHT_SAMPLE_MS = 50U;
constexpr uint16_t LIGHT_CONFIRM_MS = 1000U;

static_assert(LIGHT_ON_BRIGHTNESS < LIGHT_OFF_BRIGHTNESS &&
              LIGHT_OFF_BRIGHTNESS <= 1023U, "Invalid light hysteresis");
static_assert(LIGHT_SAMPLE_MS > 0U && LIGHT_CONFIRM_MS >= LIGHT_SAMPLE_MS,
              "Invalid light timing");
// D0/D1 are USB serial; D8/D9 are AltSoftSerial; A4/A5 are I2C.
static_assert(!LIGHT_OUTPUT_ENABLED ||
              (LIGHT_RELAY_PIN >= 2 && LIGHT_RELAY_PIN <= 13 &&
               LIGHT_RELAY_PIN != 8 && LIGHT_RELAY_PIN != 9 &&
               (LIGHT_RELAY_ON_LEVEL == LOW || LIGHT_RELAY_ON_LEVEL == HIGH)),
              "Assign a free relay pin and known ON level before enabling light output");

// The TOF-10120 datasheet gives the 8-bit address as 0xA4. Arduino Wire uses
// the corresponding 7-bit address, 0x52.
constexpr uint8_t TOF_I2C_ADDRESS = 0x52U;
constexpr uint8_t TOF_DISTANCE_REGISTER = 0x00U;
constexpr uint16_t TOF_SAMPLE_PERIOD_MS = 50U;
constexpr uint16_t TOF_MIN_VALID_DISTANCE_MM = 100U;
constexpr uint16_t TOF_MAX_VALID_DISTANCE_MM = 2000U;

// 측정 필터는 0.3, 정상 지면 기준 추적은 0.02. 오차/변화/연속 프레임 조건을 함께 사용한다.
constexpr float TOF_FILTER_ALPHA = 0.3F;
// Fixed mounting: 442 mm above ground, 45 degrees down, 75 mm behind wheel.
// Convert the 250 mm vertical threshold to distance along the optical ray.
constexpr float TOF_GROUND_DISTANCE_MM = 442.0F * 1.41421356F;
constexpr float TOF_ERROR_THRESHOLD_MM = 250.0F * 1.41421356F;
constexpr uint8_t TOF_BASELINE_SAMPLES = 10U;
constexpr uint8_t TOF_REQUIRED_FRAMES = 4U;
constexpr uint16_t TOF_RED_HOLD_MS = 1000U;

// GY-521 MPU6050 shares A4/A5 with the TOF. AD0 selects 0x68 or 0x69.
// ToF와 같은 I2C 버스를 사용하며 AD0 상태에 따라 MPU 주소를 선택한다.
constexpr bool ENABLE_MPU6050 = true;
constexpr uint8_t MPU6050_ADDRESS_LOW = 0x68U;
constexpr uint8_t MPU6050_ADDRESS_HIGH = 0x69U;
constexpr uint16_t MPU6050_SAMPLE_PERIOD_MS = 50U;
// DLPF is enabled, so the MPU6050 register source rate is 1 kHz. A divider
// of 49 makes the sensor output rate match the firmware's 20 Hz read rate.
constexpr uint8_t MPU6050_SAMPLE_RATE_DIVIDER = 49U;
constexpr uint16_t MPU6050_RECONNECT_PERIOD_MS = 1000U;
constexpr uint8_t MPU6050_MAX_CONSECUTIVE_ERRORS = 3U;
// Mounting convention used by the attitude equations: +X forward, +Y left,
// +Z up. The runtime pitch offset and sign are calibrated on the Pi.
// 각도 EMA 계수. 작을수록 부드럽지만 응답이 늦다. 장착 offset과 부호는 Pi 설정에서 보정한다.
constexpr float MPU6050_ATTITUDE_ALPHA = 0.15F;

// 설정값의 범위와 센서 출력/읽기 주기 일치를 컴파일 시 검사한다.
static_assert(
    TOF_MIN_VALID_DISTANCE_MM < TOF_MAX_VALID_DISTANCE_MM,
    "TOF valid range is invalid");
static_assert(
    TELEMETRY_PERIOD_MS >= TOF_SAMPLE_PERIOD_MS,
    "telemetry must not run faster than TOF sampling");
static_assert(
    SESSION_LOSS_TIMEOUT_MS > HELLO_PERIOD_MS * 2U,
    "session timeout must allow multiple HELLO replies");
static_assert(
    TOF_FILTER_ALPHA > 0.0F && TOF_FILTER_ALPHA <= 1.0F,
    "TOF filter alpha must be in (0, 1]");
static_assert(
    TOF_REQUIRED_FRAMES > 0U,
    "TOF required frame count must be positive");
static_assert(
    TOF_BASELINE_SAMPLES >= TOF_REQUIRED_FRAMES,
    "TOF baseline must contain enough samples");
static_assert(
    (1000UL / (static_cast<uint32_t>(MPU6050_SAMPLE_RATE_DIVIDER) + 1UL)) *
            MPU6050_SAMPLE_PERIOD_MS ==
        1000UL,
    "MPU6050 output and firmware sample periods must match");
static_assert(
    MPU6050_ATTITUDE_ALPHA > 0.0F && MPU6050_ATTITUDE_ALPHA <= 1.0F,
    "MPU6050 attitude alpha must be in (0, 1]");

}  // namespace safestride_terrain_config
