Hanjingyu625/SafeStride/prototypes/ezhmi_display/firmware/terrain_mcu/tof10120_sensor.cpp

// 하향 ToF로 기준 지면과의 거리 차이를 감시한다. 단위는 mm이다.
// 거리가 짧아지면 돌출물, 길어지면 낙차 후보로 보고 연속 측정으로 확정한다.

#include "tof10120_sensor.h"

#include <math.h>
#include <Wire.h>

#include "config.h"

namespace {

namespace cfg = safestride_terrain_config;

}  // namespace

Tof10120Sensor::Tof10120Sensor()
    : initialized_(false),
      valid_(false),
      red_hold_active_(false),
      baseline_count_(0U),
      consecutive_count_(0U),
      candidate_direction_(0),
      last_sample_ms_(0UL),
      last_red_ms_(0UL),
      distance_mm_(0xFFFFU),
      filtered_mm_(0.0F),
      reference_mm_(0.0F),
      error_mm_(0.0F),
      change_mm_(0.0F),
      alert_(TofAlert::INVALID),
      last_hazard_alert_(TofAlert::INVALID) {}

void Tof10120Sensor::begin(uint32_t now_ms) {
  last_sample_ms_ = now_ms - cfg::TOF_SAMPLE_PERIOD_MS;
}

void Tof10120Sensor::update(uint32_t now_ms) {
  if (now_ms - last_sample_ms_ < cfg::TOF_SAMPLE_PERIOD_MS) {
    return;
  }
  last_sample_ms_ = now_ms;

  const uint16_t distance = readDistanceI2c();
  if (distance < cfg::TOF_MIN_VALID_DISTANCE_MM ||
      distance > cfg::TOF_MAX_VALID_DISTANCE_MM) {
    valid_ = false;
    consecutive_count_ = 0U;
    candidate_direction_ = 0;
    alert_ = TofAlert::INVALID;
    return;
  }

  classify(now_ms, distance);
}

// I2C로 2바이트 거리를 읽는다. 통신 실패는 0xFFFF로 표시하며 update()에서 무효 처리한다.
uint16_t Tof10120Sensor::readDistanceI2c() {
  Wire.beginTransmission(cfg::TOF_I2C_ADDRESS);
  Wire.write(cfg::TOF_DISTANCE_REGISTER);
  if (Wire.endTransmission() != 0U) {
    return 0xFFFFU;
  }

  delayMicroseconds(50U);

  if (Wire.requestFrom(cfg::TOF_I2C_ADDRESS, static_cast<uint8_t>(2U)) !=
      2U) {
    return 0xFFFFU;
  }
  if (Wire.available() < 2) {
    return 0xFFFFU;
  }

  const uint8_t high_byte = static_cast<uint8_t>(Wire.read());
  const uint8_t low_byte = static_cast<uint8_t>(Wire.read());
  return static_cast<uint16_t>(
      (static_cast<uint16_t>(high_byte) << 8U) | low_byte);
}

void Tof10120Sensor::classify(
    uint32_t now_ms,
    uint16_t distance_mm) {
  distance_mm_ = distance_mm;
  if (!initialized_) {
    filtered_mm_ = static_cast<float>(distance_mm);
    reference_mm_ = cfg::TOF_GROUND_DISTANCE_MM;
    error_mm_ = 0.0F;
    change_mm_ = 0.0F;
    initialized_ = true;
    baseline_count_ = 1U;
    valid_ = false;
    alert_ = TofAlert::INVALID;
    return;
  }

  // 거리 EMA로 잡음을 줄인 뒤 기준과의 차이(error), 직전 측정과의 변화(change)를 계산한다.
  const float previous_filtered = filtered_mm_;
  filtered_mm_ = cfg::TOF_FILTER_ALPHA * static_cast<float>(distance_mm) +
                 (1.0F - cfg::TOF_FILTER_ALPHA) * filtered_mm_;
  error_mm_ = filtered_mm_ - reference_mm_;
  change_mm_ = filtered_mm_ - previous_filtered;

  // Warm the downward-looking filter before declaring the sensor ready.
  // During warmup tof_valid=false is diagnostic-only and cannot start a stop.
  // 초기 10개 측정 동안에는 valid=false이며 정상/위험 지면으로 확정하지 않는다.
  // Never learn a startup obstacle as the ground plane.
  if (baseline_count_ < cfg::TOF_BASELINE_SAMPLES) {
    ++baseline_count_;
    error_mm_ = filtered_mm_ - reference_mm_;
    valid_ = baseline_count_ >= cfg::TOF_BASELINE_SAMPLES;
    alert_ = valid_ ? TofAlert::NORMAL : TofAlert::INVALID;
    return;
  }
  valid_ = true;

  // 양수 오차는 지면이 멀어진 낙차, 음수 오차는 가까워진 돌출물 후보이다.
  int8_t direction = 0;
  if (error_mm_ >= cfg::TOF_ERROR_THRESHOLD_MM) {
    direction = 1;  // Ground is farther away: drop/hole.
  } else if (error_mm_ <= -cfg::TOF_ERROR_THRESHOLD_MM) {
    direction = -1;  // Ground/object is closer: raised edge.
  }

  if (direction == 0) {
    consecutive_count_ = 0U;
    candidate_direction_ = 0;
  } else {
    const bool same_direction = candidate_direction_ == direction;
    if (!same_direction) {
      consecutive_count_ = 1U;
      candidate_direction_ = direction;
    } else if (consecutive_count_ > 0U &&
               consecutive_count_ < cfg::TOF_REQUIRED_FRAMES) {
      // Once a real transition starts, a persistent residual counts even as
      // the EMA's per-frame change becomes small.
      ++consecutive_count_;
    }
  }

  // 변화가 시작되고 같은 방향의 오차가 필요한 횟수만큼 지속돼야 위험을 확정한다.
  if (direction != 0 &&
      consecutive_count_ >= cfg::TOF_REQUIRED_FRAMES) {
    red_hold_active_ = true;
    last_red_ms_ = now_ms;
    last_hazard_alert_ = direction > 0
        ? TofAlert::DROP
        : TofAlert::RAISED;
  }
  if (red_hold_active_ &&
      now_ms - last_red_ms_ >= cfg::TOF_RED_HOLD_MS) {
    red_hold_active_ = false;
  }

  if (red_hold_active_) {
    alert_ = last_hazard_alert_;
  } else if (direction > 0) {
    alert_ = TofAlert::CANDIDATE_DROP;
  } else if (direction < 0) {
    alert_ = TofAlert::CANDIDATE_RAISED;
  } else {
    alert_ = TofAlert::NORMAL;
    // Keep the surveyed ground reference fixed: slow obstacles must not be
    // absorbed by baseline adaptation. Recalibrate after changing the mount.
  }
}

bool Tof10120Sensor::valid() const {
  return valid_;
}

uint16_t Tof10120Sensor::distanceMm() const {
  return valid_ ? distance_mm_ : 0xFFFFU;
}

float Tof10120Sensor::filteredDistanceMm() const {
  return filtered_mm_;
}

float Tof10120Sensor::referenceDistanceMm() const {
  return reference_mm_;
}

float Tof10120Sensor::errorMm() const {
  return error_mm_;
}

float Tof10120Sensor::changeMm() const {
  return change_mm_;
}

TofAlert Tof10120Sensor::alert() const {
  return alert_;
}
