Hanjingyu625/SafeStride/src/safestride_bridge/safestride_bridge/protocol.py

"""Wire protocol shared by the SafeStride ROS bridge and controller firmware.

Every packet is COBS encoded and terminated by a zero byte.  The decoded
packet consists of a fixed little-endian header, a variable payload and a
CRC16-CCITT-FALSE.  This module intentionally has no ROS dependencies so it
can be unit-tested on any development machine.
"""

from __future__ import annotations

from dataclasses import dataclass
from enum import IntEnum
import struct
from typing import ClassVar, Iterable, List


PROTOCOL_VERSION = 6
PROTOCOL_SCHEMA_ID = 0x0601
FIRMWARE_RELEASE_ID = 20260908

BOARD_ROLE_DRIVE = 1
BOARD_ROLE_TERRAIN = 2
FRAME_DELIMITER = 0x00
MAX_RAW_FRAME_SIZE = 128

HEADER_STRUCT = struct.Struct('<BBBBHHII')
CRC_STRUCT = struct.Struct('<H')

HELLO_STRUCT = struct.Struct('<IIBBHI')
SESSION_START_STRUCT = struct.Struct('<IBBHI')
COMMAND_STRUCT = struct.Struct('<iHBBhBB')
TELEMETRY_STRUCT = struct.Struct('<iiiiHHHhhHHHHHHHBBhhhIBB')
# Protocol v4 keeps the original 45-byte payload for compatibility. The final
# 14 bytes were GPS data and are now reserved because GPS is owned by the Pi.
TERRAIN_TELEMETRY_STRUCT = struct.Struct(
    '<HBBHHhhhhhhhhhhBH14x'
)


class ProtocolError(ValueError):
    """Base class for malformed wire data."""


class CobsDecodeError(ProtocolError):
    """Raised when an encoded COBS packet is malformed."""


class FrameDecodeError(ProtocolError):
    """Raised when a decoded packet violates the frame format."""


class CrcMismatchError(FrameDecodeError):
    """Raised when a packet CRC does not match its contents."""


class UnsupportedVersionError(FrameDecodeError):
    """Raised when a frame belongs to a different wire protocol."""

    def __init__(self, observed: int, expected: int) -> None:
        self.observed = int(observed)
        self.expected = int(expected)
        super().__init__(
            f'unsupported protocol version {observed}; expected {expected}'
        )


class PayloadDecodeError(ProtocolError):
    """Raised when a typed payload has an unexpected size or value."""


class PacketType(IntEnum):
    """SafeStride protocol packet type identifiers."""

    HELLO = 0x01
    SESSION_START = 0x02
    COMMAND = 0x10
    TELEMETRY = 0x20
    TERRAIN_TELEMETRY = 0x21


def crc16_ccitt_false(data: bytes) -> int:
    """Return CRC16-CCITT-FALSE (poly 0x1021, init 0xffff)."""

    crc = 0xFFFF
    for byte in data:
        crc ^= byte << 8
        for _ in range(8):
            if crc & 0x8000:
                crc = ((crc << 1) ^ 0x1021) & 0xFFFF
            else:
                crc = (crc << 1) & 0xFFFF
    return crc


def sequence_is_newer(candidate: int, reference: int) -> bool:
    """Compare uint16 sequences using their half-range wraparound rule."""

    candidate = _u16('candidate', candidate)
    reference = _u16('reference', reference)
    delta = (candidate - reference) & 0xFFFF
    return 0 < delta < 0x8000


def cobs_encode(data: bytes) -> bytes:
    """Encode *data* using Consistent Overhead Byte Stuffing."""

    output = bytearray((0,))
    code_index = 0
    code = 1

    for byte in data:
        if byte == 0:
            output[code_index] = code
            code_index = len(output)
            output.append(0)
            code = 1
        else:
            output.append(byte)
            code += 1
            if code == 0xFF:
                output[code_index] = code
                code_index = len(output)
                output.append(0)
                code = 1

    output[code_index] = code
    return bytes(output)


def cobs_decode(data: bytes) -> bytes:
    """Decode one COBS packet without its trailing delimiter."""

    if not data:
        raise CobsDecodeError('empty COBS packet')
    if 0 in data:
        raise CobsDecodeError('COBS packet contains a zero byte')

    output = bytearray()
    index = 0
    size = len(data)
    while index < size:
        code = data[index]
        index += 1
        block_end = index + code - 1
        if block_end > size:
            raise CobsDecodeError('COBS code exceeds packet length')
        output.extend(data[index:block_end])
        index = block_end
        if code != 0xFF and index < size:
            output.append(0)
    return bytes(output)


def _u8(name: str, value: int) -> int:
    if not 0 <= int(value) <= 0xFF:
        raise ValueError(f'{name} must fit uint8')
    return int(value)


def _u16(name: str, value: int) -> int:
    if not 0 <= int(value) <= 0xFFFF:
        raise ValueError(f'{name} must fit uint16')
    return int(value)


def _u32(name: str, value: int) -> int:
    if not 0 <= int(value) <= 0xFFFFFFFF:
        raise ValueError(f'{name} must fit uint32')
    return int(value)


@dataclass(frozen=True)
class Frame:
    """A decoded protocol frame."""

    packet_type: int
    sequence: int
    session_id: int
    timestamp_ms: int
    payload: bytes = b''
    flags: int = 0
    reserved: int = 0
    version: int = PROTOCOL_VERSION

    def __post_init__(self) -> None:
        _u8('version', self.version)
        _u8('packet_type', self.packet_type)
        _u8('flags', self.flags)
        _u8('reserved', self.reserved)
        _u16('sequence', self.sequence)
        _u32('session_id', self.session_id)
        _u32('timestamp_ms', self.timestamp_ms)
        if not isinstance(self.payload, bytes):
            object.__setattr__(self, 'payload', bytes(self.payload))
        _u16('payload length', len(self.payload))

    @property
    def type(self) -> int:
        """Compatibility alias matching the header field name."""

        return self.packet_type

    def raw_bytes(self) -> bytes:
        """Serialize the decoded portion, including its CRC."""

        header = HEADER_STRUCT.pack(
            self.version,
            self.packet_type,
            self.flags,
            self.reserved,
            self.sequence,
            len(self.payload),
            self.session_id,
            self.timestamp_ms,
        )
        checked = header + self.payload
        return checked + CRC_STRUCT.pack(crc16_ccitt_false(checked))

    def encode(self) -> bytes:
        """Serialize, COBS encode and append the 0x00 delimiter."""

        return cobs_encode(self.raw_bytes()) + bytes((FRAME_DELIMITER,))


def encode_frame(frame: Frame) -> bytes:
    """Encode a :class:`Frame` for the serial wire."""

    return frame.encode()


def decode_frame(encoded: bytes) -> Frame:
    """Decode one COBS frame.

    A single trailing delimiter is accepted for convenience.  Embedded or
    additional delimiters are rejected by the COBS decoder.
    """

    if encoded.endswith(bytes((FRAME_DELIMITER,))):
        encoded = encoded[:-1]
    raw = cobs_decode(encoded)

    minimum_size = HEADER_STRUCT.size + CRC_STRUCT.size
    if len(raw) < minimum_size:
        raise FrameDecodeError('frame is shorter than header plus CRC')
    if len(raw) > MAX_RAW_FRAME_SIZE:
        raise FrameDecodeError(
            f'decoded frame exceeds {MAX_RAW_FRAME_SIZE} bytes'
        )

    checked = raw[:-CRC_STRUCT.size]
    received_crc = CRC_STRUCT.unpack(raw[-CRC_STRUCT.size:])[0]
    expected_crc = crc16_ccitt_false(checked)
    if received_crc != expected_crc:
        raise CrcMismatchError(
            f'CRC mismatch: received 0x{received_crc:04x}, '
            f'expected 0x{expected_crc:04x}'
        )

    (
        version,
        packet_type,
        flags,
        reserved,
        sequence,
        payload_length,
        session_id,
        timestamp_ms,
    ) = HEADER_STRUCT.unpack(raw[:HEADER_STRUCT.size])

    if version != PROTOCOL_VERSION:
        raise UnsupportedVersionError(version, PROTOCOL_VERSION)
    if flags != 0:
        raise FrameDecodeError('unsupported nonzero header flags')
    if reserved != 0:
        raise FrameDecodeError('header reserved field must be zero')
    actual_payload_length = len(raw) - minimum_size
    if payload_length != actual_payload_length:
        raise FrameDecodeError(
            f'payload length is {payload_length}, '
            f'but frame contains {actual_payload_length}'
        )

    return Frame(
        version=version,
        packet_type=packet_type,
        flags=flags,
        reserved=reserved,
        sequence=sequence,
        session_id=session_id,
        timestamp_ms=timestamp_ms,
        payload=raw[HEADER_STRUCT.size:-CRC_STRUCT.size],
    )


class FrameParser:
    """Incrementally split and decode a serial byte stream."""

    def __init__(self, max_encoded_size: int = 160) -> None:
        if max_encoded_size < 2:
            raise ValueError('max_encoded_size must be at least 2')
        self.max_encoded_size = int(max_encoded_size)
        self._buffer = bytearray()
        self._dropping_oversize = False
        self.frames_received = 0
        self.crc_error_count = 0
        self.frame_error_count = 0
        self.version_error_count = 0
        self.last_unsupported_version: int | None = None

    def reset(self, clear_counters: bool = False) -> None:
        """Discard a partial packet, optionally resetting statistics."""

        self._buffer.clear()
        self._dropping_oversize = False
        if clear_counters:
            self.frames_received = 0
            self.crc_error_count = 0
            self.frame_error_count = 0
            self.version_error_count = 0
            self.last_unsupported_version = None

    def feed(self, data: Iterable[int]) -> List[Frame]:
        """Consume bytes and return every complete, valid frame."""

        frames: List[Frame] = []
        for value in data:
            byte = int(value)
            if not 0 <= byte <= 0xFF:
                raise ValueError('stream elements must fit uint8')

            if byte == FRAME_DELIMITER:
                if self._dropping_oversize:
                    self._dropping_oversize = False
                    self._buffer.clear()
                    continue
                if not self._buffer:
                    continue
                try:
                    frame = decode_frame(bytes(self._buffer))
                except CrcMismatchError:
                    self.crc_error_count += 1
                except UnsupportedVersionError as error:
                    self.version_error_count += 1
                    self.last_unsupported_version = error.observed
                except ProtocolError:
                    self.frame_error_count += 1
                else:
                    self.frames_received += 1
                    frames.append(frame)
                finally:
                    self._buffer.clear()
                continue

            if self._dropping_oversize:
                continue
            if len(self._buffer) >= self.max_encoded_size:
                self.frame_error_count += 1
                self._buffer.clear()
                self._dropping_oversize = True
                continue
            self._buffer.append(byte)
        return frames


def _require_size(payload_name: str, data: bytes, expected: int) -> None:
    if len(data) != expected:
        raise PayloadDecodeError(
            f'{payload_name} payload must be {expected} bytes, '
            f'got {len(data)}'
        )


@dataclass(frozen=True)
class HelloPayload:
    """HELLO payload sent by firmware while waiting for a session."""

    boot_id: int
    capabilities: int
    board_role: int
    protocol_version: int = PROTOCOL_VERSION
    schema_id: int = PROTOCOL_SCHEMA_ID
    firmware_release_id: int = FIRMWARE_RELEASE_ID
    TYPE: ClassVar[PacketType] = PacketType.HELLO

    def pack(self) -> bytes:
        return HELLO_STRUCT.pack(
            _u32('boot_id', self.boot_id),
            _u32('capabilities', self.capabilities),
            _u8('board_role', self.board_role),
            _u8('protocol_version', self.protocol_version),
            _u16('schema_id', self.schema_id),
            _u32('firmware_release_id', self.firmware_release_id),
        )

    @classmethod
    def unpack(cls, data: bytes) -> 'HelloPayload':
        _require_size('HELLO', data, HELLO_STRUCT.size)
        return cls(*HELLO_STRUCT.unpack(data))


@dataclass(frozen=True)
class SessionStartPayload:
    """SESSION_START payload sent by the host after a HELLO."""

    expected_boot_id: int
    expected_board_role: int
    protocol_version: int = PROTOCOL_VERSION
    schema_id: int = PROTOCOL_SCHEMA_ID
    firmware_release_id: int = FIRMWARE_RELEASE_ID
    TYPE: ClassVar[PacketType] = PacketType.SESSION_START

    def pack(self) -> bytes:
        return SESSION_START_STRUCT.pack(
            _u32('expected_boot_id', self.expected_boot_id),
            _u8('expected_board_role', self.expected_board_role),
            _u8('protocol_version', self.protocol_version),
            _u16('schema_id', self.schema_id),
            _u32('firmware_release_id', self.firmware_release_id),
        )

    @classmethod
    def unpack(cls, data: bytes) -> 'SessionStartPayload':
        _require_size('SESSION_START', data, SESSION_START_STRUCT.size)
        return cls(*SESSION_START_STRUCT.unpack(data))


@dataclass(frozen=True)
class CommandPayload:
    """COMMAND payload containing one shared signed target in mrad/s."""

    target_mrad_s: int
    ttl_ms: int
    enable: int
    reserved: int = 0
    slope_ff_pwm: int = 0
    drive_pwm_cap: int = 140
    mode: int = 0
    TYPE: ClassVar[PacketType] = PacketType.COMMAND

    def pack(self) -> bytes:
        if self.enable not in (0, 1):
            raise ValueError('enable must be 0 or 1')
        if self.reserved != 0:
            raise ValueError('COMMAND reserved field must be zero')
        if not -60 <= self.slope_ff_pwm <= 45:
            raise ValueError('slope_ff_pwm must be in [-60, 45]')
        if not 0 <= self.drive_pwm_cap <= 140 or self.mode not in (0, 1, 2):
            raise ValueError('invalid drive cap or mode')
        if self.mode != 0 and (self.target_mrad_s != 0 or self.slope_ff_pwm != 0):
            raise ValueError('BRAKE requires zero target and slope FF')
        return COMMAND_STRUCT.pack(
            int(self.target_mrad_s),
            _u16('ttl_ms', self.ttl_ms),
            _u8('enable', self.enable),
            _u8('reserved', self.reserved),
            int(self.slope_ff_pwm),
            _u8('drive_pwm_cap', self.drive_pwm_cap),
            _u8('mode', self.mode),
        )

    @classmethod
    def unpack(cls, data: bytes) -> 'CommandPayload':
        _require_size('COMMAND', data, COMMAND_STRUCT.size)
        payload = cls(*COMMAND_STRUCT.unpack(data))
        try:
            payload.pack()
        except ValueError as error:
            raise PayloadDecodeError(str(error)) from error
        if payload.enable not in (0, 1):
            raise PayloadDecodeError('COMMAND enable must be 0 or 1')
        if payload.reserved != 0:
            raise PayloadDecodeError('COMMAND reserved field must be zero')
        return payload


@dataclass(frozen=True)
class TelemetryPayload:
    """TELEMETRY payload returned by the motor controller."""

    hall_left_pulses: int
    hall_right_pulses: int
    velocity_left_mrad_s: int
    velocity_right_mrad_s: int
    range_left_mm: int
    range_right_mm: int
    battery_mv: int
    current_left_ma: int
    current_right_ma: int
    status_bits: int
    fault_bits: int
    last_command_sequence: int
    pressure_left_raw: int = 0xFFFF
    pressure_right_raw: int = 0xFFFF
    pressure_left_filtered: int = 0xFFFF
    pressure_right_filtered: int = 0xFFFF
    pressure_flags: int = 0
    pressure_alert: int = 0
    ff_pwm: int = 0
    feedback_pwm: int = 0
    applied_pwm: int = 0
    speed_age_us: int = 0xFFFFFFFF
    speed_flags: int = 0
    drive_mode: int = 1
    TYPE: ClassVar[PacketType] = PacketType.TELEMETRY

    def pack(self) -> bytes:
        if self.pressure_flags & ~0x07:
            raise ValueError('pressure_flags contains reserved bits')
        if self.pressure_alert not in (0, 1, 2):
            raise ValueError('pressure_alert must be 0, 1 or 2')
        return TELEMETRY_STRUCT.pack(
            int(self.hall_left_pulses),
            int(self.hall_right_pulses),
            int(self.velocity_left_mrad_s),
            int(self.velocity_right_mrad_s),
            _u16('range_left_mm', self.range_left_mm),
            _u16('range_right_mm', self.range_right_mm),
            _u16('battery_mv', self.battery_mv),
            int(self.current_left_ma),
            int(self.current_right_ma),
            _u16('status_bits', self.status_bits),
            _u16('fault_bits', self.fault_bits),
            _u16('last_command_sequence', self.last_command_sequence),
            _u16('pressure_left_raw', self.pressure_left_raw),
            _u16('pressure_right_raw', self.pressure_right_raw),
            _u16('pressure_left_filtered', self.pressure_left_filtered),
            _u16('pressure_right_filtered', self.pressure_right_filtered),
            _u8('pressure_flags', self.pressure_flags),
            _u8('pressure_alert', self.pressure_alert),
            int(self.ff_pwm), int(self.feedback_pwm), int(self.applied_pwm),
            _u32('speed_age_us', self.speed_age_us),
            _u8('speed_flags', self.speed_flags),
            _u8('drive_mode', self.drive_mode),
        )

    @classmethod
    def unpack(cls, data: bytes) -> 'TelemetryPayload':
        _require_size('TELEMETRY', data, TELEMETRY_STRUCT.size)
        payload = cls(*TELEMETRY_STRUCT.unpack(data))
        if payload.speed_flags & ~0x03 or payload.drive_mode not in (0, 1):
            raise PayloadDecodeError('invalid drive telemetry flags/mode')
        if payload.pressure_flags & ~0x07:
            raise PayloadDecodeError(
                'pressure_flags contains reserved bits'
            )
        if payload.pressure_alert not in (0, 1, 2):
            raise PayloadDecodeError(
                'pressure_alert must be 0, 1 or 2'
            )
        return payload


@dataclass(frozen=True)
class TerrainTelemetryPayload:
    """Sensor telemetry returned by the terrain controller."""

    tof_distance_mm: int
    tof_valid: int
    tof_alert: int
    tof_filtered_mm: int
    tof_reference_mm: int
    tof_error_mm: int
    tof_change_mm: int
    mpu_accel_x_mg: int
    mpu_accel_y_mg: int
    mpu_accel_z_mg: int
    mpu_gyro_x_mrad_s: int
    mpu_gyro_y_mrad_s: int
    mpu_gyro_z_mrad_s: int
    mpu_roll_mrad: int
    mpu_pitch_mrad: int
    mpu_valid: int
    fault_bits: int
    TYPE: ClassVar[PacketType] = PacketType.TERRAIN_TELEMETRY

    def pack(self) -> bytes:
        if self.tof_valid not in (0, 1):
            raise ValueError('tof_valid must be 0 or 1')
        if not 0 <= self.tof_alert <= 5:
            raise ValueError('tof_alert must be in [0, 5]')
        if self.mpu_valid not in (0, 1):
            raise ValueError('mpu_valid must be 0 or 1')
        return TERRAIN_TELEMETRY_STRUCT.pack(
            _u16('tof_distance_mm', self.tof_distance_mm),
            _u8('tof_valid', self.tof_valid),
            _u8('tof_alert', self.tof_alert),
            _u16('tof_filtered_mm', self.tof_filtered_mm),
            _u16('tof_reference_mm', self.tof_reference_mm),
            int(self.tof_error_mm),
            int(self.tof_change_mm),
            int(self.mpu_accel_x_mg),
            int(self.mpu_accel_y_mg),
            int(self.mpu_accel_z_mg),
            int(self.mpu_gyro_x_mrad_s),
            int(self.mpu_gyro_y_mrad_s),
            int(self.mpu_gyro_z_mrad_s),
            int(self.mpu_roll_mrad),
            int(self.mpu_pitch_mrad),
            _u8('mpu_valid', self.mpu_valid),
            _u16('fault_bits', self.fault_bits),
        )

    @classmethod
    def unpack(cls, data: bytes) -> 'TerrainTelemetryPayload':
        _require_size(
            'TERRAIN_TELEMETRY', data, TERRAIN_TELEMETRY_STRUCT.size
        )
        payload = cls(*TERRAIN_TELEMETRY_STRUCT.unpack(data))
        if payload.tof_valid not in (0, 1):
            raise PayloadDecodeError('tof_valid must be 0 or 1')
        if not 0 <= payload.tof_alert <= 5:
            raise PayloadDecodeError('tof_alert must be in [0, 5]')
        if payload.mpu_valid not in (0, 1):
            raise PayloadDecodeError('mpu_valid must be 0 or 1')
        return payload
