Hanjingyu625/SafeStride/(commit log)

2026-07-24 Initial SafeStride ROS 2 smart walker
    [safestride.urdf.xacro]
2026-08-11 Feat: ROS-Jazzy에 맞춘 WS
    [hardware.example.yaml]
2026-08-11 FIX: yml파일을 yaml로 수정
2026-08-11 Fix: readme 수정
2026-08-12 Fix: 조이스틱 기능 삭제 및 빌드 테스트 완료
    [config.h, firmware_state_machine_test.cpp, raspberry_pi.yaml, safestride.yaml, safestride_mcu.ino, safety_logic.py, safety_supervisor_node.py, serial_bridge_node.py]
2026-08-12 Integrate pressure, TOF, and dual motor control
2026-08-12 Integrate GPS crosswalk controller into ROS 2
    [hardware.example.yaml]
2026-08-12 Fix Arduino sketch duplicate entry points
2026-08-12 Restore Raspberry Pi walking assistant code
    [crosswalk_controller_log.csv, crosswalk_live_log.csv, crosswalk_log.csv, current_position.csv, pressure_session.csv]
2026-08-12 Organize Raspberry Pi walking assistant code
    [crosswalk_controller_log.csv, crosswalk_live_log.csv, crosswalk_log.csv, current_position.csv, pressure_session.csv]
2026-08-14 Integrate Hall-based shared drive and terrain sensing
    [hardware.example.yaml, safestride.urdf.xacro]
2026-08-14 Add magnet-trigger motor bench mode
2026-08-19 Replace magnet trigger with Hall speed feedback
    [hardware.example.yaml]
2026-08-19 Support single drive Hall sensor
2026-08-19 Run drive open loop without Hall feedback
2026-08-19 Reduce perception load on Raspberry Pi
2026-08-24 Replace Hall feedback with wheel encoder feedback
    [hardware.example.yaml]
2026-08-25 Restore Hall feedback and fix pressure telemetry
    [hardware.example.yaml]
2026-08-27 Implement TOF terrain safety and MPU6050 integration
    [hardware.example.yaml]
2026-08-27 Document Raspberry Pi bringup and ROS topic checks
2026-08-27 Fix pdj final test execution
    [firmware_pressure_sensor_test.cpp]
2026-08-27 Use A1 A2 for drive pressure sensors
2026-08-27 Drive directly from pressure deadman
2026-08-27 Restore motor startup PWM compensation
2026-08-27 Make Hall telemetry-only in deadman drive mode
2026-08-27 Use open-loop PWM in deadman drive mode
2026-08-31 Calibrate IMU gravity and finalize Pi sensor bridge
    [hardware.example.yaml]
2026-08-31 Align pressure wiring and Pi GPS serial path
    [hardware.example.yaml]
2026-08-31 Fix GPS tracking and crosswalk selection
    [hardware.example.yaml]
2026-09-01 Fix live GPS crosswalk matching
    [current_position.csv]
2026-09-01 Filter stationary GPS drift for crosswalk tracking
    [gps_node.py, gps_speed_filter.py, nmea.py, raspberry_pi.yaml, safestride.yaml]
2026-09-01 Reject coherent stationary GPS drift
    [gps_node.py, gps_speed_filter.py, raspberry_pi.yaml, safestride.yaml]
2026-09-01 Require Hall odometry for crosswalk motion
2026-09-01 Complete Foxglove live dashboard
    # Conflicts:
    # config/raspberry_pi.yaml
    # src/safestride_bringup/config/safestride.yaml
2026-09-01 Support analog WSH135 Hall sensor
    [hardware.example.yaml, safestride.urdf.xacro]
2026-09-01 Publish compressed camera preview
2026-09-02 Add slope-aware closed-loop drive control
    [hardware.example.yaml]
2026-09-06 Implement slope feed-forward speed control and automatic BRAKE recovery
2026-09-06 Fix supervisor subscription initialization and enforce ROS API test signatures
    [safety_supervisor_node.py, test_drive_contract.py]
2026-09-07 Reset pressure filter on confirmed release
    [firmware_pressure_sensor_test.cpp, firmware_state_machine_test.cpp, pressure_sensor.cpp]
2026-09-09 Revert "Merge pdj1 into main with slope drive control"
    This reverts commit 36df55157ad24797a6f9525ef72b05e6fb48eb51, reversing
    changes made to 735263f6bccdbb7bf40cd6b7940fe0613ef7c435.
    [config.h, firmware_motor_control_test.cpp, firmware_protocol_test.cpp, firmware_state_machine_test.cpp, motor_control.cpp, motor_control.h, protocol.h, protocol.py]
2026-09-09 Update SafeStride control and hardware integration
    [hardware.example.yaml]
2026-09-09 Integrate terrain stop and speed control updates
    [hardware.example.yaml]
2026-09-10 Apply SafeStride local changes
    [hardware.example.yaml]
2026-09-10 Fix raw-pitch slope control and ramp downhill stops at 30 degrees
    [raspberry_pi.yaml, safestride.yaml, safety_logic.py, safety_supervisor_node.py, terrain_bridge_node.py, test_drive_contract.py, test_hardware_integrity.py]
2026-09-14 Add ezHMI display prototype and four-panel UI simulator
2026-09-14 Document ezHMI Windows setup and wiring
2026-09-14 Integrate ezHMI display telemetry and LCD runtime into pdj1
    [controls.csv, registers.csv]
2026-09-14 Add native VisualTFT display project
    [controls.csv]
2026-09-14 Use ASCII text for VisualTFT display
    [controls.csv]
2026-09-14 Set walking target to 1 m/s with PWM 20 launch and revised slope thresholds
2026-09-17 Tune slope PWM assistance, enable downhill slowdown, and raise PWM cap to 140
2026-09-17 Enable USB camera dashboard and keep ToF and surface recognition monitoring-only
2026-09-17 Zero terrain status pitch and roll using measured level reference
2026-09-17 Lower both handle pressure thresholds from 40 to 35
2026-09-21 Fix VisualTFT live display updates
    [controls.csv]
2026-09-22 Replace stale LCD location placeholder with GPS status
    [controls.csv]
2026-09-22 Add HMI v3 location and surface display
    [controls.csv, registers.csv]
2026-09-22 Add Raspberry Pi branch deployment switcher
2026-09-22 Fix crossing signal handling and publish readable guidance
    [test_crossing_policy.py, test_crosswalk_guidance.py, test_signal_phase.py]
2026-09-22 Add Terrain A0 lighting logic with relay output gated until configured
2026-09-23 Add light sensor connection information to README
2026-09-23 Strengthen launch and uphill assist and ramp downhill PWM over three seconds
    [config.h, firmware_motor_control_test.cpp, firmware_state_machine_test.cpp, motor_control.cpp, protocol.py, raspberry_pi.yaml, safestride.yaml, safestride_mcu.ino]
2026-09-23 Start downhill fade at seven degrees and improve surface and signal acceptance
    [hardware.example.yaml]
2026-09-27 Replace analogue Hall input with A314x interrupt pulse capture
    [config.h, digital_hall_sensor.cpp, digital_hall_sensor.h, firmware_digital_hall_sensor_test.cpp, firmware_state_machine_test.cpp, safestride_mcu.ino, test_hardware_integrity.py]
2026-09-27 Enable Terrain ambient light relay output
2026-09-28 Improve crosswalk selection with GPS and gyro heading fusion
2026-09-28 Fix live signal endpoints and enforce API backoff across candidates
    [probe_signal_current.py, test_signal_http.py, test_signal_polling.py]
2026-09-28 Stabilize GPS crosswalk selection and signal direction estimates
    [raspberry_pi.yaml, test_navigation_adapter.py, test_navigation_matching.py]
2026-09-29 Fix LCD post office location truncation
    [hmi_model.py]
2026-10-01 Fix red countdown display and hold GPS position during standstill
    [registers.csv]
